Reclone-org/AccessLabs-Resources/hardware/Shaker/Readme.md

# AccessLabs Incubator Shaker

<p align="center">
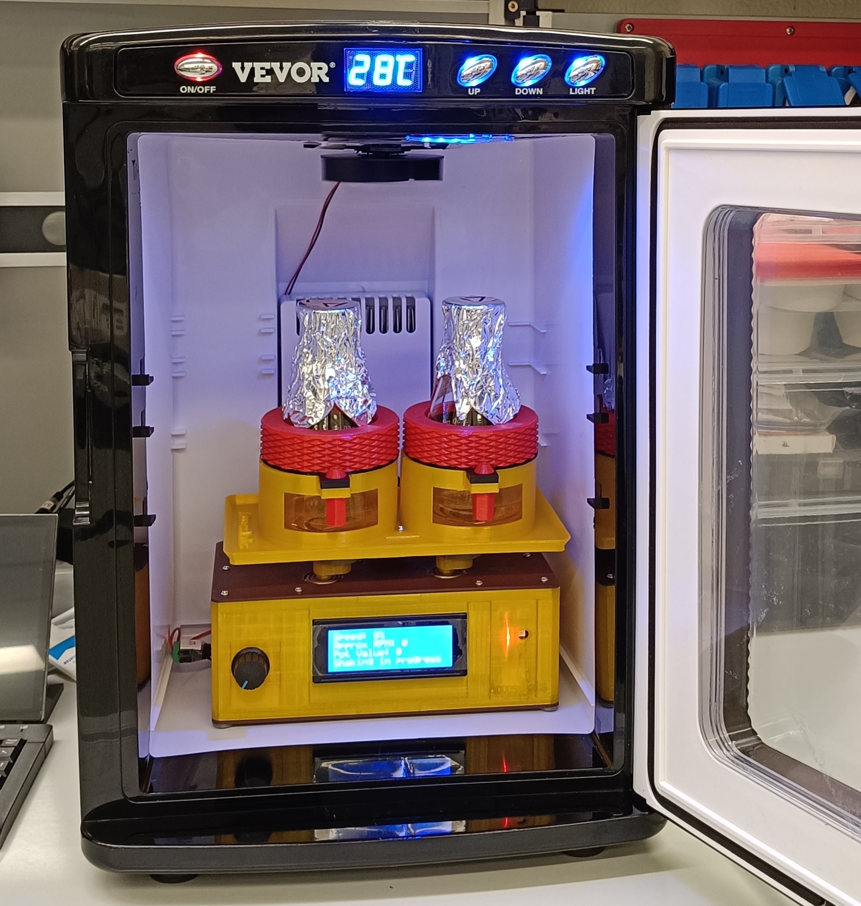
[picture p1: hardware/Shaker/Images/Assmebled1.jpg]
Assembled shaker
  
</p>

<p align="center">
  <strong>3D-printed incubator shaker</strong><br>
  ESP32-S3 controlled, motor-driven, modular, and designed for interchangeable lab vessel adapters.
</p>

<p align="center">
  <em>Prototype hardware documented for replication, testing, and further improvement.</em>
</p>

---

## Overview

This repository documents the design and construction of a compact incubator shaker built around:

- a **3D-printed mechanical assembly**
- an **ESP32-S3 DevKitC-1** controller
- a **DC gear motor**
- a **DRV8871 motor driver**
- interchangeable adapters for **flasks**, **tubes**, and **plates**

The aim of the project is to provide a reproducible open-hardware shaker that is easy to print, assemble, adapt, and improve for different laboratory applications. The shaker was designed with a compact footprint to fit inside small laboratory incubators and operate as a shaking incubator.

---

## Features

- Modular 3D-printed design
- Interchangeable tray adapters
- ESP32-S3 based control
- PWM motor speed control
- LCD and RGB LED feedback
- Open documentation for replication and customization

<p align="center">
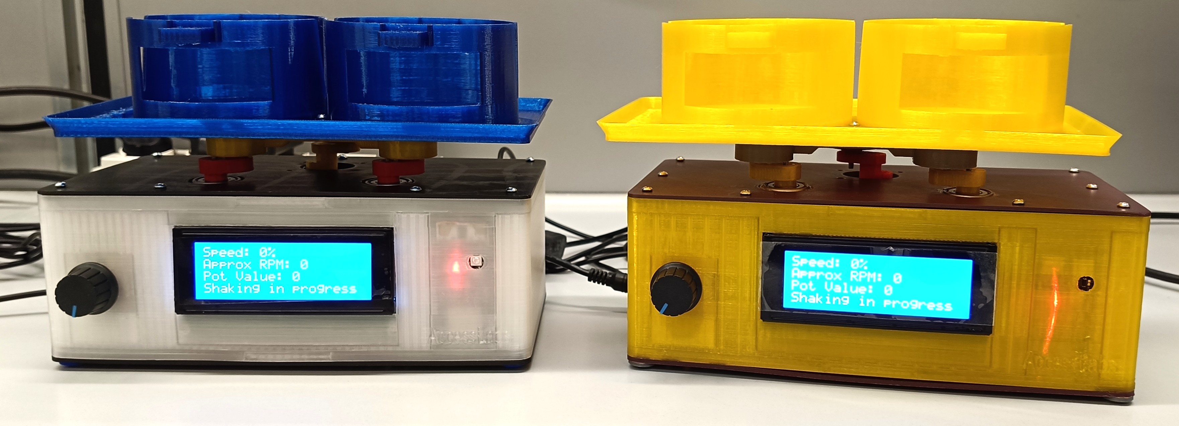
[picture p2: hardware/Shaker/Assembly-and-set-up/Assembled shaker2_1.jpg]
Fully assembled shaker front view
  
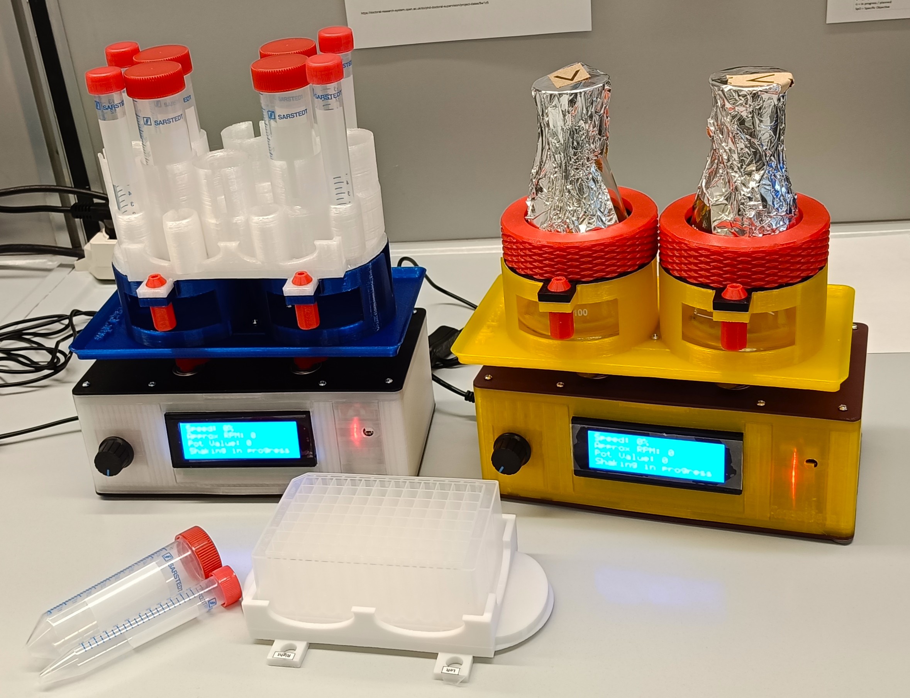
[picture p3: hardware/Shaker/Assembly-and-set-up/Assembled shaker2_2..jpg]
Fully assembled shaker angled view
  
</p>
---

## Bill of Materials

### 3D-printed parts

| Part name | Qty |
|---|---:|
| `Tray_Main Platform` | 1 |
| `Tray_Screws and nuts` | 2 |
| `Flask adapter_Lid` | 2 |
| `Flask adapter_Lid retainer` | 2 |
| `Plate adapter` | 1 |
| `Tube adapter_15 mL and 50 mL` | 1 |
| `Motion Mechanism_Tray Support Bracket` | 1 |
| `Motion Mechanism_Motor motion linker (6mm Shaft)` | 1 |
| `Motion Mechanism_Connecting Link` | 2 |
| `Motion Mechanism_Nut holders` | 2 |
| `Motion Mechanism_Screw holders` | 1 set |
| `Enclosure_Main Housing` | 1 |
| `Enclosure_Gear Motor Mount` | 1 |
| `Enclosure_Top Cover` | 1 |
| `Enclosure_Base Cover` | 1 |
| `Enclosure_Feet` | 1 set |

### 3D model previews

The 3D-printable parts are provided as STL files. Click any animated preview below to open the corresponding STL file in GitHub's interactive 3D viewer.

| Part | Animated preview | STL file |
|---|---|---|
| Enclosure base cover | <a href="3D%20models/Enclosure_Base%20Cover.stl">Enclosure base cover preview</a> | [`Enclosure_Base Cover.stl`](3D%20models/Enclosure_Base%20Cover.stl) |
| Enclosure feet | <a href="3D%20models/Enclosure_Feet.stl">Enclosure feet preview</a> | [`Enclosure_Feet.stl`](3D%20models/Enclosure_Feet.stl) |
| Gear motor mount | <a href="3D%20models/Enclosure_Gear%20Motor%20Mount.stl">Gear motor mount preview</a> | [`Enclosure_Gear Motor Mount.stl`](3D%20models/Enclosure_Gear%20Motor%20Mount.stl) |
| Main housing | <a href="3D%20models/Enclosure_Main%20Housing.stl">Main housing preview</a> | [`Enclosure_Main Housing.stl`](3D%20models/Enclosure_Main%20Housing.stl) |
| Top cover | <a href="3D%20models/Enclosure_Top%20Cover.stl">Top cover preview</a> | [`Enclosure_Top Cover.stl`](3D%20models/Enclosure_Top%20Cover.stl) |
| Flask adapter lid retainer | <a href="3D%20models/Flask%20adapter_Lid%20retainer%20%28Print%202%20copies%29.stl">Flask adapter lid retainer preview</a> | [`Flask adapter_Lid retainer (Print 1 set).stl`](3D%20models/Flask%20adapter_Lid%20retainer%20%28Print%202%20copies%29.stl) |
| Flask adapter lid | <a href="3D%20models/Flask%20adapter_Lid_%28Print%202%20copies%29.stl">Flask adapter lid preview</a> | [`Flask adapter_Lid_(Print 2 copies).stl`](3D%20models/Flask%20adapter_Lid_%28Print%202%20copies%29.stl) |
| Connecting link | <a href="3D%20models/Motion%20Mechanism_Connecting%20Link%20%28Print%20two%20copies%29.stl">Connecting link preview</a> | [`Motion Mechanism_Connecting Link (Print two copies).stl`](3D%20models/Motion%20Mechanism_Connecting%20Link%20%28Print%20two%20copies%29.stl) |
| Motor motion linker | <a href="3D%20models/Motion%20Mechanism_Motor%20motion%20linker%20%286mm%20Shaft%29.stl">Motor motion linker preview</a> | [`Motion Mechanism_Motor motion linker (6mm Shaft).stl`](3D%20models/Motion%20Mechanism_Motor%20motion%20linker%20%286mm%20Shaft%29.stl) |
| Nut holders | <a href="3D%20models/Motion%20Mechanism_Nut%20holders%20%28Print%20two%20copies%29.stl">Nut holders preview</a> | [`Motion Mechanism_Nut holders (Print two copies).stl`](3D%20models/Motion%20Mechanism_Nut%20holders%20%28Print%20two%20copies%29.stl) |
| Screw holders | <a href="3D%20models/Motion%20Mechanism_Screw%20holders.stl">Screw holders preview</a> | [`Motion Mechanism_Screw holders.stl`](3D%20models/Motion%20Mechanism_Screw%20holders.stl) |
| Tray support bracket | <a href="3D%20models/Motion%20Mechanism_Tray%20Support%20Bracket.stl">Tray support bracket preview</a> | [`Motion Mechanism_Tray Support Bracket.stl`](3D%20models/Motion%20Mechanism_Tray%20Support%20Bracket.stl) |
| Plate adapter | <a href="3D%20models/Plate%20adapter.stl">Plate adapter preview</a> | [`Plate adapter.stl`](3D%20models/Plate%20adapter.stl) |
| Tray main platform | <a href="3D%20models/Tray_Main%20Platform.stl">Tray main platform preview</a> | [`Tray_Main Platform.stl`](3D%20models/Tray_Main%20Platform.stl) |
| Tray screws and nuts | <a href="3D%20models/Tray_Screws%20and%20nuts%20%28Print%202%20copies%20of%20each%29.stl">Tray screws and nuts preview</a> | [`Tray_Screws and nuts (Print 2 sets).stl`](3D%20models/Tray_Screws%20and%20nuts%20%28Print%202%20copies%20of%20each%29.stl) |
| Tube adapter, 15 mL and 50 mL | <a href="3D%20models/Tube%20Adapter_15%20mL%20and%2050%20mL.stl">Tube adapter preview</a> | [`Tube Adapter_15 mL and 50 mL.stl`](3D%20models/Tube%20Adapter_15%20mL%20and%2050%20mL.stl) |

### Purchased parts

#### Enclosure and mechanism

| Item | Qty | Cost | Supplier | Notes |
|---|---:|---:|---|---|
| 608ZZ miniature double-protection metal ball bearings (`8 mm x 22 mm x 7 mm`) | 1 | €10.99 | Amazon | / |
| M3 screws, bolts, nuts, and washers kit (`870 pcs`) | 1 | €14.98 | Amazon | / |

#### Electronics

| Item | Qty | Cost | Supplier | Notes |
|---|---:|---:|---|---|
| ESP32-S3 DevKitC-1 microcontroller | 1 | €22.99 | Amazon | Used due to availability. Offers potential for future upgrades. |
| DRV8871 DC motor driver board (`3.6 A`, PWM control) | 2 | €9.99 | Amazon | MOSFET-based H-bridge with lower power loss, higher current handling, wider voltage range, and built-in protection features for improved reliability during prolonged operation. |
| 10K rotary potentiometer with cap and washer | 1 | €8.99 | Amazon | Input device for speed control. |
| 12 V DC worm geared motor (`370WG`, `375 RPM`) | 2 | €18.99 | Amazon | Preferred choice for cost effectiveness. Recommended to use similar motor with high torque and biuilt with better materials for prolonged use. |
| DC barrel power connector / jack adapter set | 1 | €7.99 | Amazon | Includes multiple connectors and inline rocker switches; useful for other projects as well. |
| 12 V power cable / adapter | 2 | €12.90 | Amazon | Portable design with multi-project adapter compatibility reduces future tooling costs. |
| LM2596 step-down DC-DC buck converter module | 1 | €11.19 | Amazon | Required to safely power the full circuit from a single 12 V external adapter via the DC jack. |
| ARCELI 20x4 2004 5 V DC LCD display module with TWI/IIC I2C interface adapter (`Blue/2004`) | 1 | €10.77 | Amazon | Used for system status display, speed display, and approximate RPM readout. I2C interface simplifies wiring to the ESP32-S3. |

### Tools and consumables

- Strong instant glue
- Screwdriver set
- Soldering station
- Jumper wires
- Double sided tape
---

## Printing recommendations

For the **critical structural and motion parts**, use **PETG** or a similar durable filament.

### Recommended print settings
- **Infill:** at least **50%**
- **Supports:** use where needed
- **Brim:** use where needed for better bed adhesion

### Critical parts
- `Enclosure_Main Housing`
- `Enclosure_Feet`
- all motion mechanism parts
- `Tray_Main Platform`
- `Tray_Screws and nuts`

### Notes
- Remove supports and brims carefully after printing.
- Clean mating surfaces and holes before assembly.
- Check bearing and nut pockets before gluing.

---

## Parts Gallery

The images below are arranged by function and labeled with the current filenames in the repository.

### 1. Tray and adapters

<table>
  <tr>
    <td align="center" width="33%">
      <strong>Tray_Main Platform.jpg</strong><br><br>
      Tray_Main Platform.jpg
    </td>
    <td align="center" width="33%">
      <strong>Tray_Screws and nuts.jpg</strong><br><br>
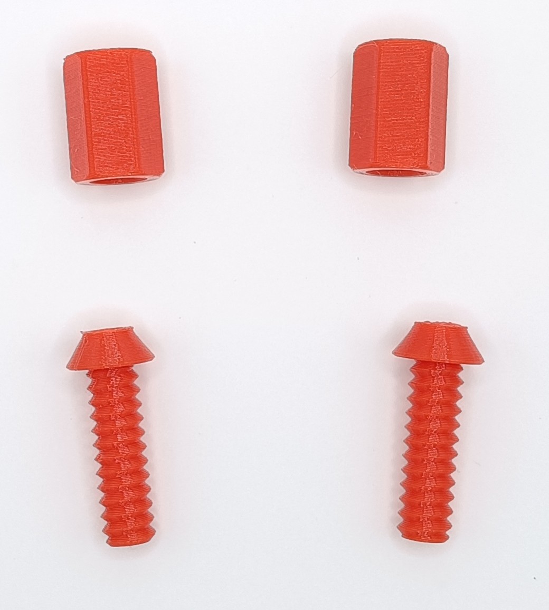
[picture p4: hardware/Shaker/Images/Tray_Screws and nuts.jpg]
Tray_Screws and nuts.jpg
      
    </td>
    <td align="center" width="33%">
      <strong>Plate adapter.jpg</strong><br><br>
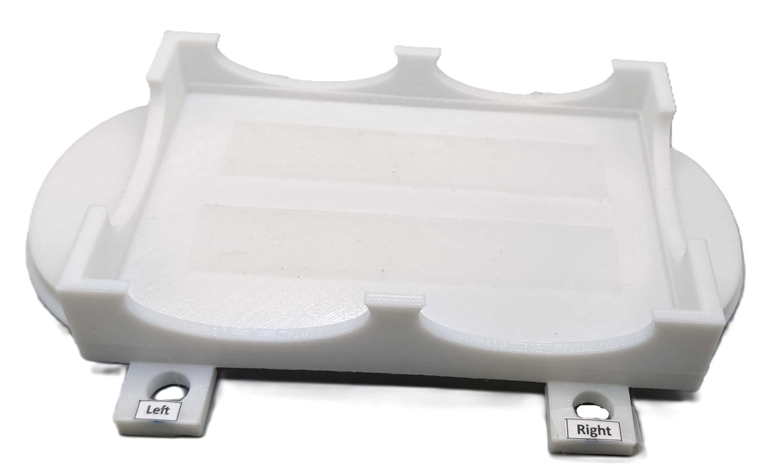
[picture p5: hardware/Shaker/Images/Plate adapter.jpg]
Plate adapter.jpg
      
    </td>
  </tr>
  <tr>
    <td align="center" width="33%">
      <strong>Tube adapter_15 mL and 50 mL.jpg</strong><br><br>
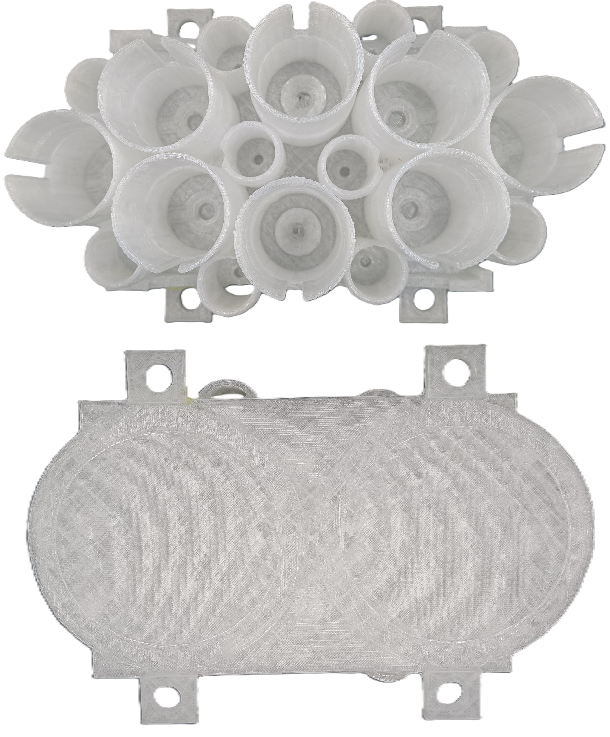
[picture p6: hardware/Shaker/Images/Tube adapter_15 mL and 50 mL.jpg]
Tube adapter_15 mL and 50 mL.jpg
      
    </td>
    <td align="center" width="33%">
      <strong>Flask adapter_Lids .jpg</strong><br><br>
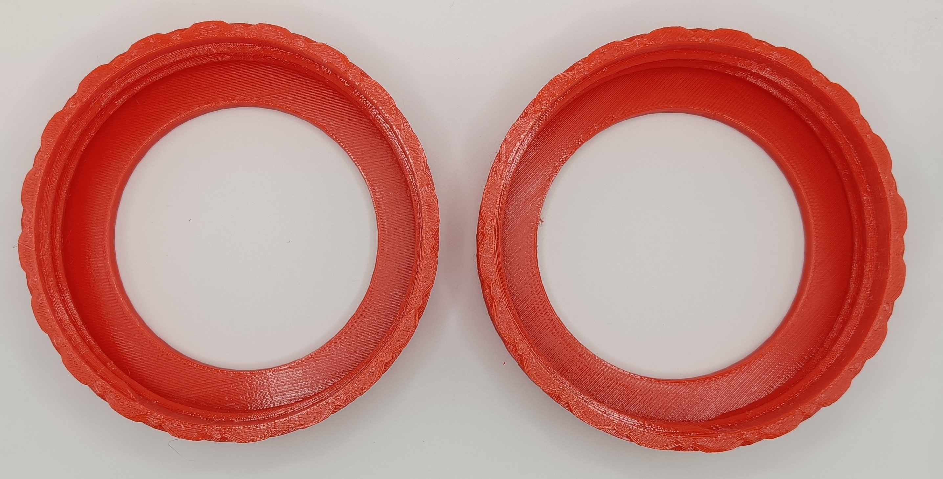
[picture p7: hardware/Shaker/Images/Flask adapter_Lids .jpg]
Flask adapter_Lids .jpg
      
    </td>
    <td align="center" width="33%">
      <strong>Flask adapter_Lid retainers.jpg</strong><br><br>
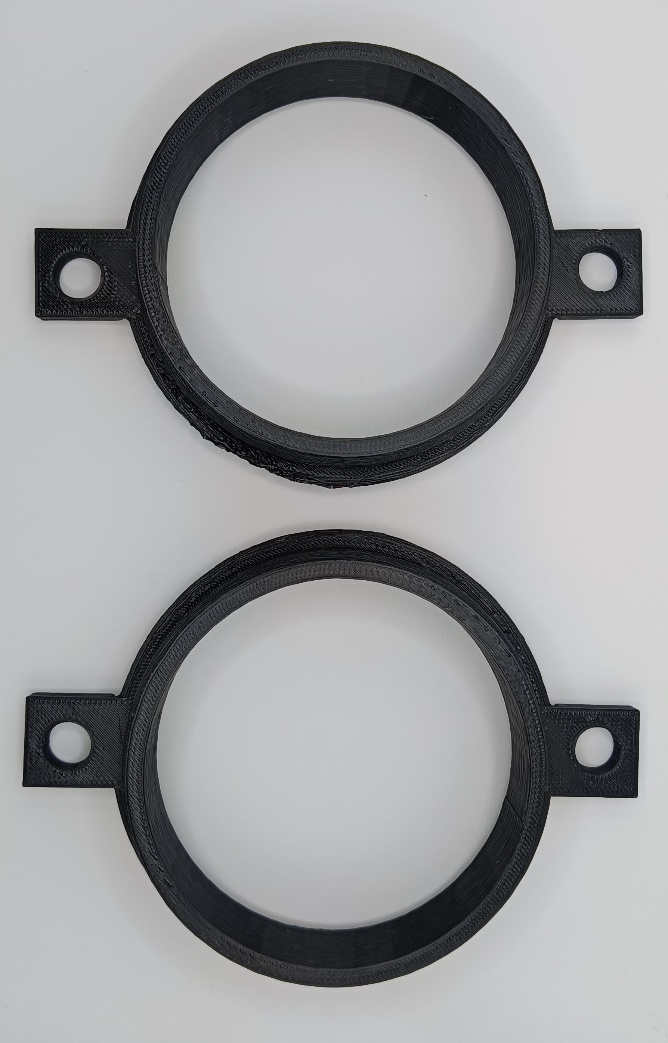
[picture p8: hardware/Shaker/Images/Flask adapter_Lid retainers.jpg]
Flask adapter_Lid retainers.jpg
      
    </td>
  </tr>
</table>

### 2. Motion assembly

<table>
  <tr>
    <td align="center" width="100%">
      <strong>Motion Mechanism parts.jpg</strong><br><br>
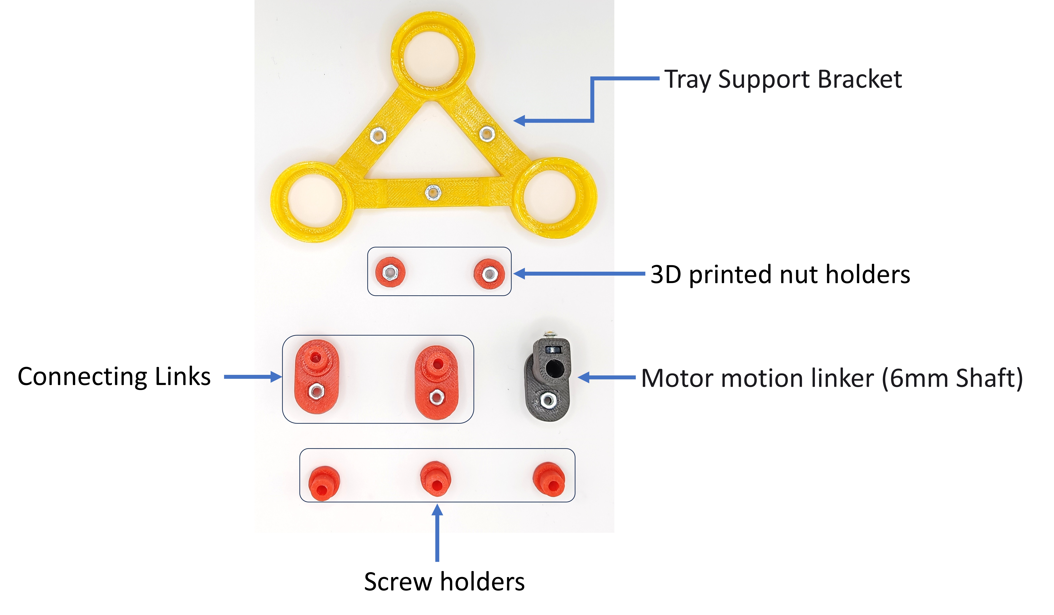
[picture p9: hardware/Shaker/Images/Motion Mechanism parts.jpg]
Motion Mechanism parts.jpg
      
    </td>
  </tr>
</table>

### 3. Enclosure

<table>
  <tr>
    <td align="center" width="33%">
      <strong>Enclosure_Main Housing.jpg</strong><br><br>
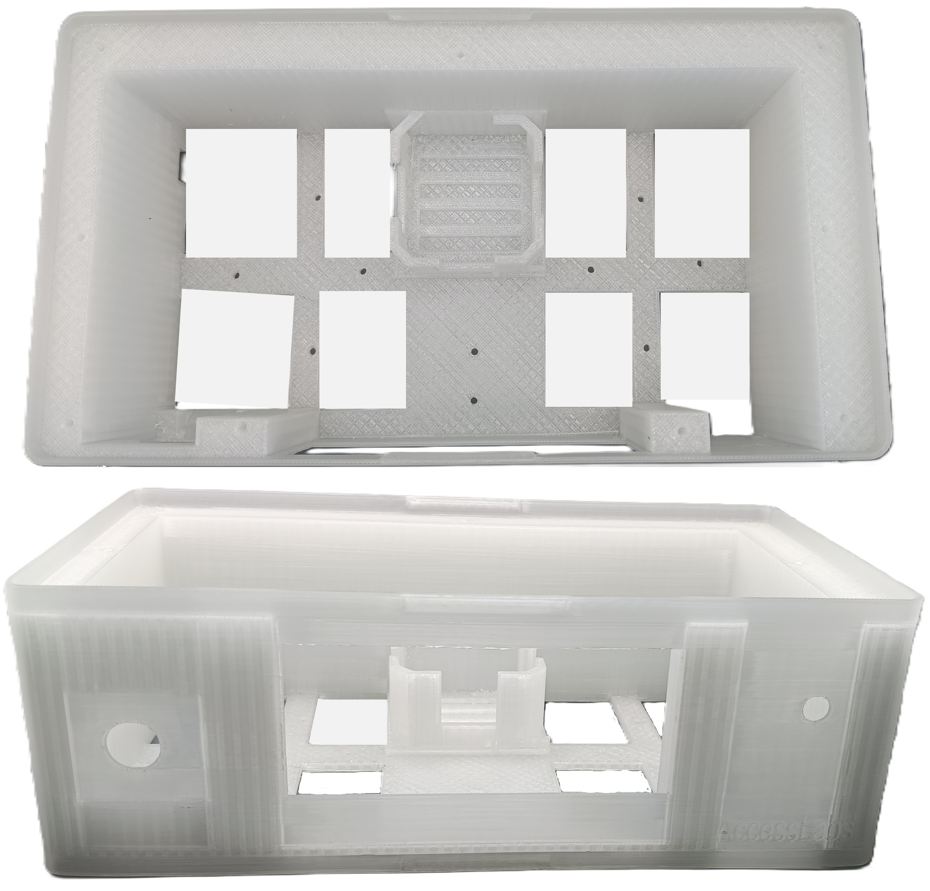
[picture p10: hardware/Shaker/Images/Enclosure_Main Housing.jpg]
Enclosure_Main Housing.jpg
      
    </td>
    <td align="center" width="33%">
      <strong>Enclosure_Top Cover.jpg</strong><br><br>
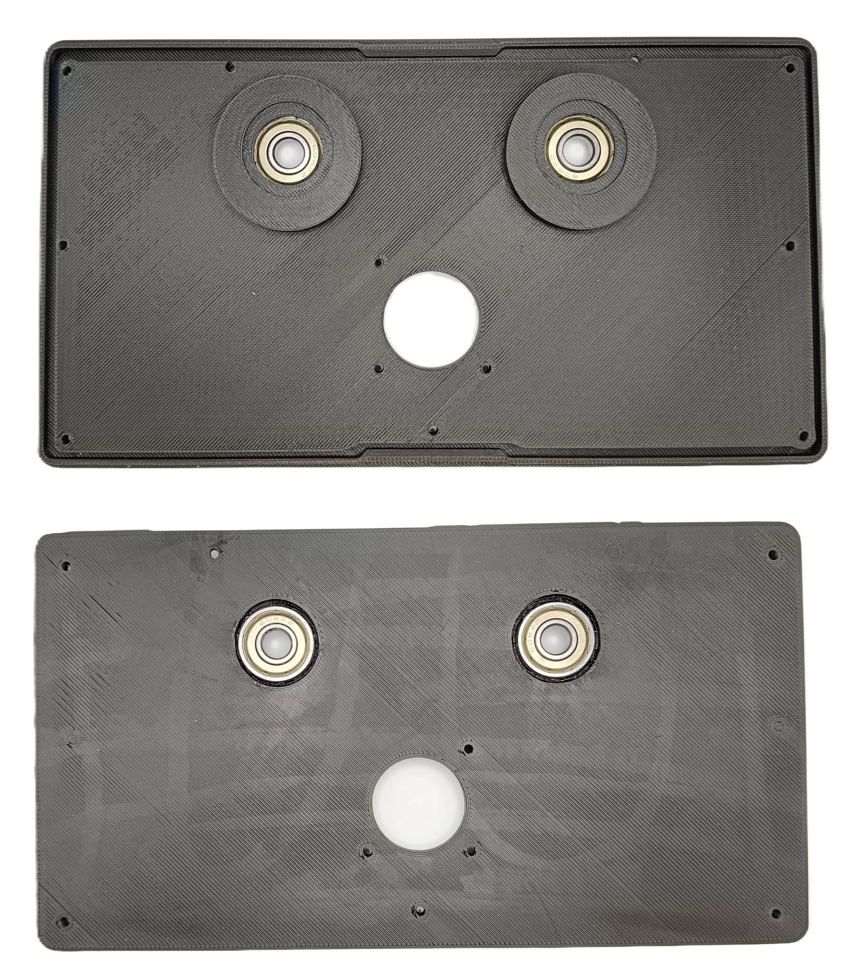
[picture p11: hardware/Shaker/Images/Enclosure_Top Cover.jpg]
Enclosure_Top Cover.jpg
      
    </td>
    <td align="center" width="33%">
      <strong>Enclosure_Base Cover.jpg</strong><br><br>
      Enclosure_Base Cover.jpg
    </td>
  </tr>
</table>

---

## Assembly

### A. Print and sort all parts

Download the 3D models and print all required parts.

After printing:
1. Remove all supports and brims.
2. Clean all holes and mating surfaces.
3. Sort the parts before starting assembly.

Recommended first check:
- verify that all bearings fit correctly
- verify that all nut pockets are clean
- verify that moving parts rotate freely

---

### B. Prepare the motion mechanism

#### Parts involved
- `Motion Mechanism_Motor motion linker (6mm Shaft)`
- `Motion Mechanism_Connecting Link`
- `Motion Mechanism_Nut holders`
- `Motion Mechanism_Screw holders`
- `Motion Mechanism_Tray Support Bracket`

#### Instructions
1. Dry-fit each M3 nut and 608ZZ bearing before gluing.
2. Apply a small amount of strong liquid glue around the nut or bearing pocket.
3. Insert the nut or bearing carefully.
4. Do **not** let glue enter:
   - threaded areas
   - the inner bearing race
   - rotating contact surfaces
5. Let the glue set for about **30 minutes**.
6. Add a small finishing layer at the interstices if needed.
7. Allow full curing according to the glue manufacturer's recommendations.

<p align="center">
  Assembly steps 1: Motion Mechanism
</p>

<p align="center">
  <em>Assembly steps 1.</em>
</p>

> **Note:** For the motor linker, the nut located around the shaft should remain unglued if required for fit and rotation.
---

### C. Prepare the enclosure

#### Parts involved
- `Enclosure_Main Housing`
- `Enclosure_Gear Motor Mount`
- `Enclosure_Top Cover`
- `Enclosure_Base Cover`
- `Enclosure_Feet`

#### Instructions
1. Install bearings in their dedicated holes of the top cover where applicable.
> **Note:**: use soft glue to fix bearings so as to enable slide movements of once glued: we used the **super 620, Glue Artiglio** which worked well for us
2. Assemble the top cover
3. Mount the gear motor in the motor holder.
4. Test fit the top and base covers before electronics assembly.
5. Check shaft alignment before tightening hardware.

<p align="center">
  Assembly steps 2
</p>

<p align="center">
  <em>Assembly steps 2.</em>
</p>

#### Top Cover assembly order

Click the preview below to download the full video.

<p align="center">
  <a href="https://github.com/Reclone-org/AccessLabs-Resources/blob/76ed58e3b9f4448dbe461207be13629689c9c077/hardware/Shaker/Assembly-and-set-up/Top%20cover%20assembly.mp4">
    Top Cover assembly order
  </a>
</p>

---

### D. Electronics assembly

#### Main electronics

- ESP32-S3 DevKitC-1
- DRV8871 motor driver
- 10K rotary potentiometer
- ARCELI 20x4 2004 LCD display module with TWI/IIC I2C interface (`5 V`, `Blue/2004`)
- LM2596 step-down DC-DC buck converter
- 12 V DC worm geared motor (`370WG`, `375 RPM`)
- 12 V DC input connector

#### Electronics overview

<p align="center">
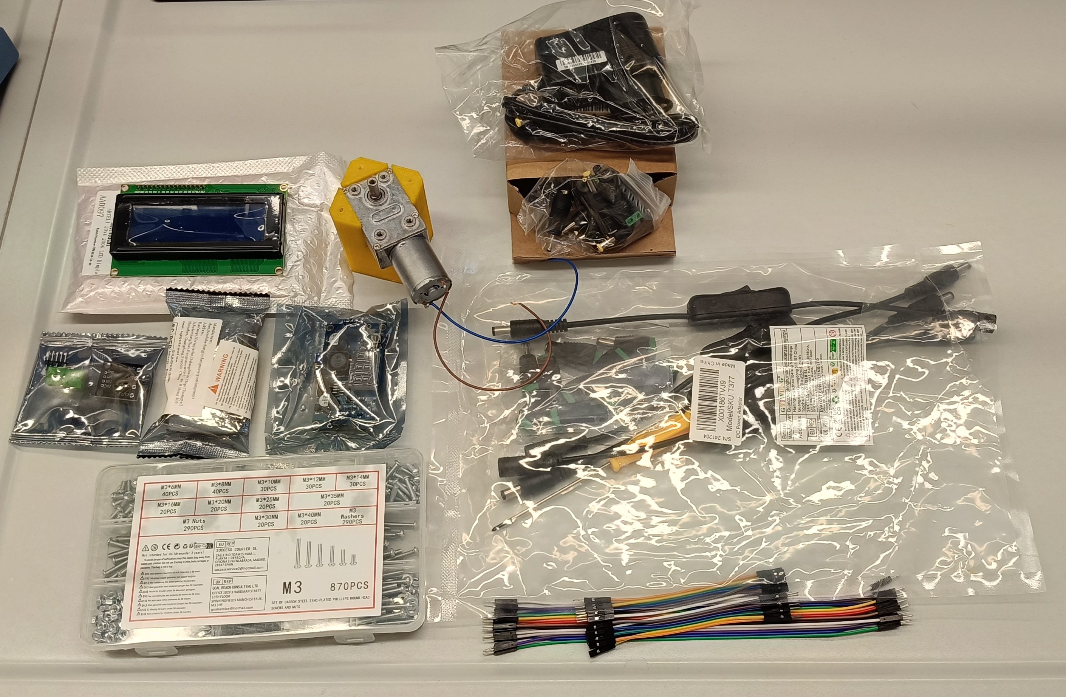
[picture p12: hardware/Shaker/Images/Electrionics parts .jpg]
Electronics parts overview
  
</p>

<p align="center">
  <em>Electronics parts used for the shaker build.</em>
</p>

#### Instructions

1. **Prepare the motor driver**  
   Solder the DRV8871 motor driver board according to the manufacturer's instructions.

2. **Connect the power input**  
   Connect the DC barrel power connector to the **input** of the LM2596 buck converter.

3. **Set the regulated output**  
   Power the LM2596 from the 12 V input.  
   Adjust the onboard potentiometer until the output is **5 V**.

4. **Wire the low-voltage electronics**  
   Connect the regulated **5 V** output and **GND** from the LM2596 to the ESP32-S3 and the LCD power lines.

5. **Connect the LCD**  
   Wire the LCD I2C backpack to:
   - **5 V**
   - **GND**
   - **SDA** on the ESP32-S3 (pin 21)
   - **SCL** on the ESP32-S3 (pin 17)

6. **Connect the control circuit**  
   Wire the potentiometer, DRV8871, ESP32-S3, and motor according to the wiring diagram.

7. **Check the wiring**  
   Before powering the full circuit, confirm that:
   - all grounds are shared
   - the LM2596 output is set to **5 V**
   - the LCD is powered from **5 V**
   - the correct pins are used for **SDA** and **SCL**
   - the ESP32-S3 pins match the firmware
   - wires are secure and clear of moving parts

#### Wiring diagram

<p align="center">
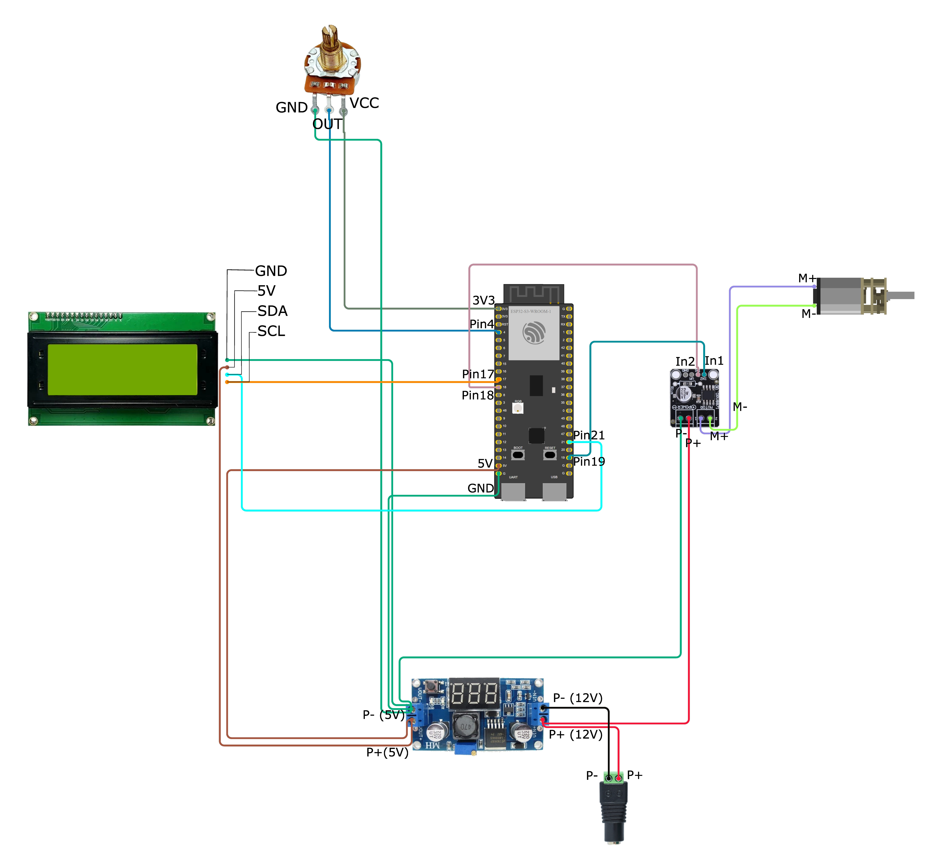
[picture p13: hardware/Shaker/Images/Circuit_Design.jpg]
Wiring diagram
  
</p>

<p align="center">
  <em>Wiring diagram for the shaker electronics assembly.</em>
</p>

#### Electronic assembly overview
<p align="center">
  Electronic assembly overview
</p>

<p align="center">
  <em>Electronic assembly overview.</em>
</p>

8. **Run a bench test**  
   Power the circuit and confirm that:
   - the ESP32-S3 starts correctly
   - the LCD initializes correctly (If needed, adjust the screen brightness by turning the contrast knob.)
   - the potentiometer input responds correctly
   - the motor driver powers on
   - the motor runs as expected

> **Important:** If you use a different ESP32 board, LCD backpack, or pin mapping, check the pinout and update the wiring and firmware as needed.

#### Circuit assembly and bench testing 
<p align="center">
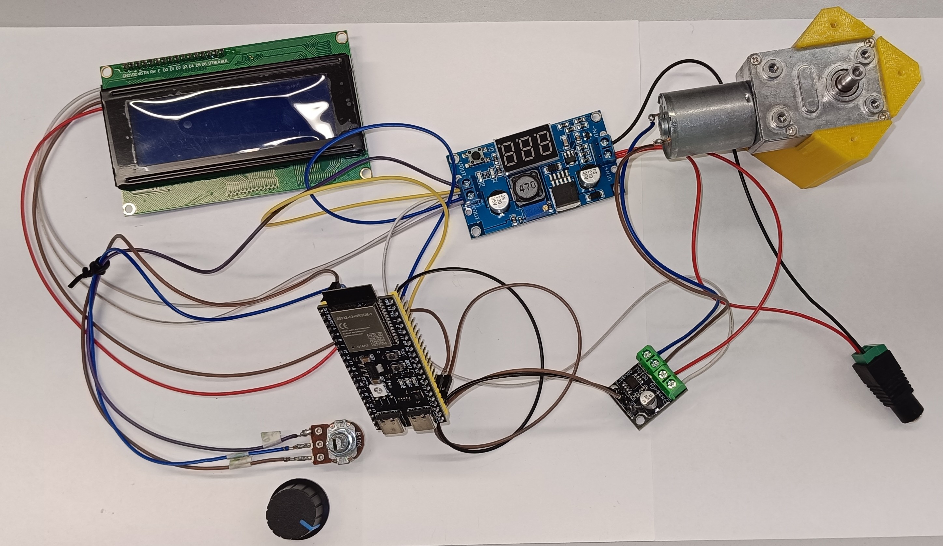
[picture p14: hardware/Shaker/Electronics/Assembled Circuit.jpg]
Electronic circuit assembly
  
</p>

<p align="center">
  <em>Electronic circuit assembly.</em>
</p>

<p align="center">
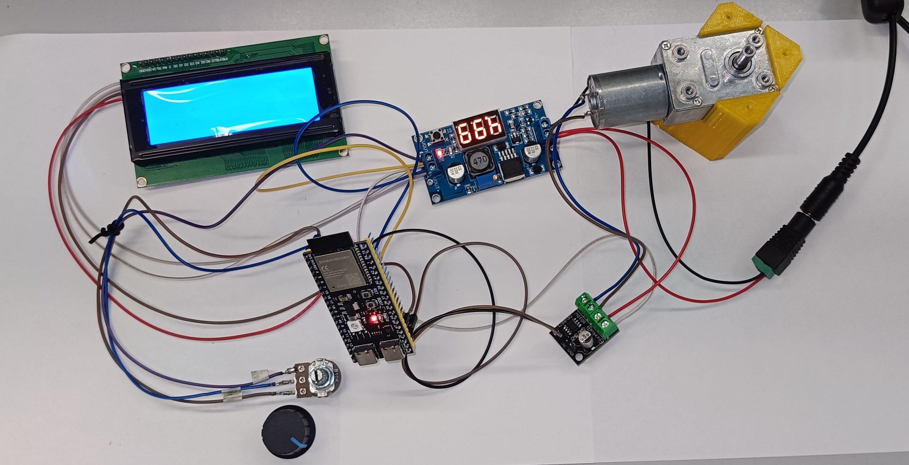
[picture p15: hardware/Shaker/Electronics/Testing the Circuit.jpg]
Bench testing
  
</p>

<p align="center">
  <em>Bench testing.</em>
</p>
---

### E. Firmware

The firmware acts as the control system for the shaker.

#### Main behavior
- scans the I2C bus at startup
- initializes the LCD
- runs a short boot animation
- reads and averages potentiometer values
- maps the input to PWM motor speed
- estimates RPM for display
- updates the LCD with:
  - speed percentage
  - approximate RPM
  - raw potentiometer value

#### Speed control logic
A dead zone is used so the shaker remains reliably off at low potentiometer values.

- `0` to about `1264` → motor off
- above `1264` → mapped linearly to PWM output
- the displayed RPM is an approximation and not encoder measured

---

### F. Software installation

#### Prerequisites

Before uploading the firmware:

1. Make sure the circuit is **not powered on**.
2. Connect the **ESP32-S3 DevKitC-1** to the computer using the board programming/COM port.
3. Install **Arduino IDE**.
4. Download the firmware from the software folder:

   [Shaker software folder](https://github.com/Reclone-org/AccessLabs-Resources/tree/841adbdfd7efff96190e474088e382160f662ce2/hardware/Shaker/Software)

5. Open the firmware file:

   **`Shaker 2.0_Program_DRV8871.ino`**

#### Using Arduino IDE

1. Open **Arduino IDE**.
2. Open the shaker firmware sketch:

   **`Shaker 2.0_Program_DRV8871.ino`**

3. Go to **Tools**.
4. Go to **Board**.
5. Select **ESP32S3 Dev Module**.

   Board selection reference:

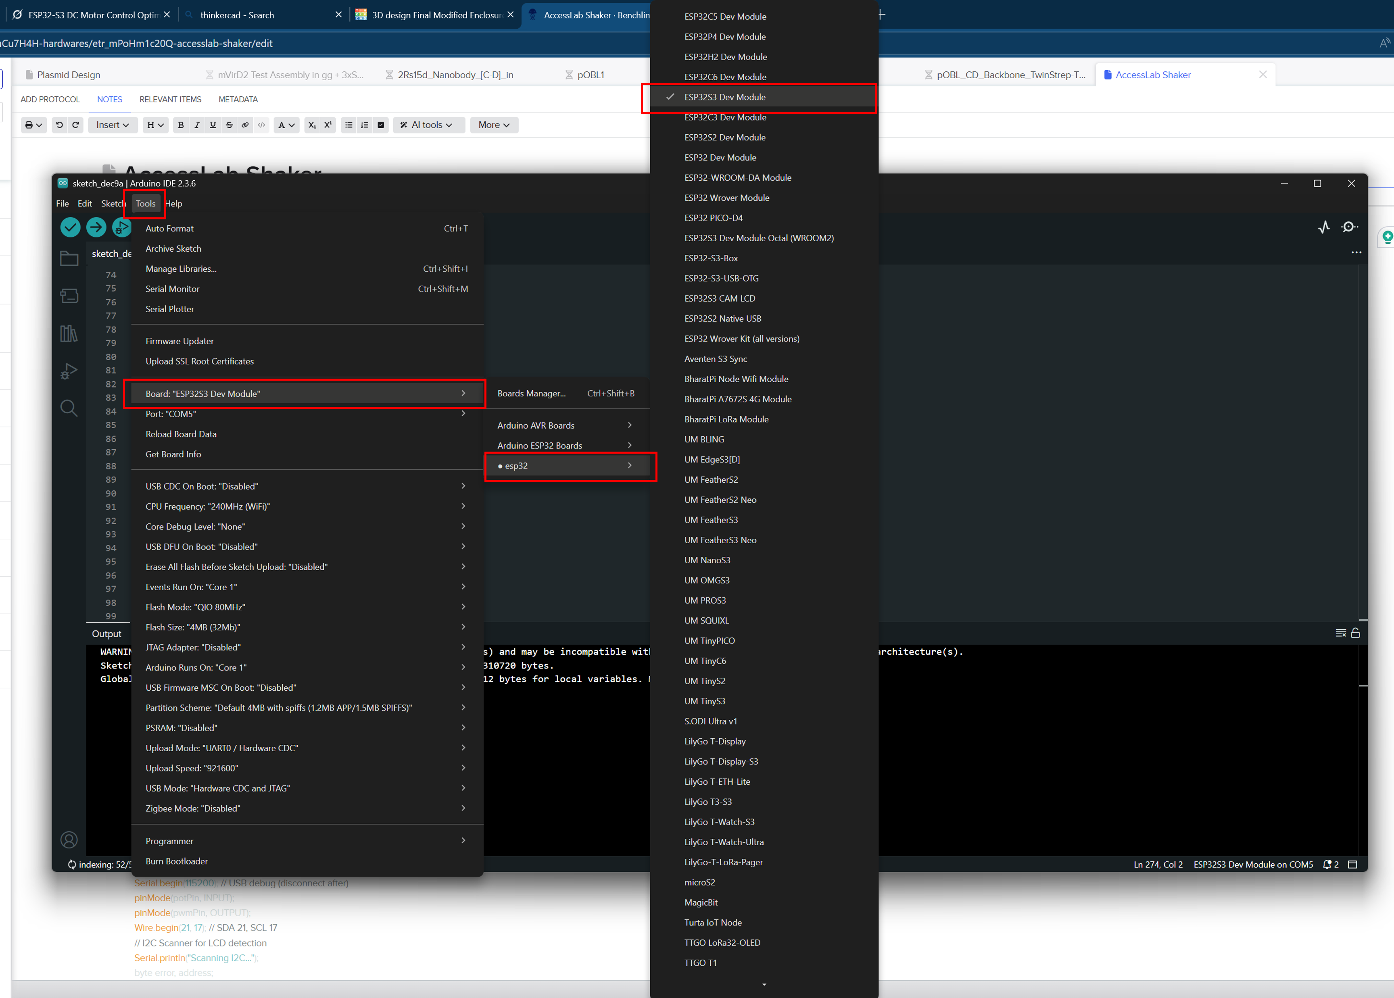
[picture p16: hardware/Shaker/Images/Board selection.png]
Board selection in Arduino IDE
   

6. Select the correct serial **Port**.
7. Click **Verify** to compile the firmware.

   Compile sketch reference:

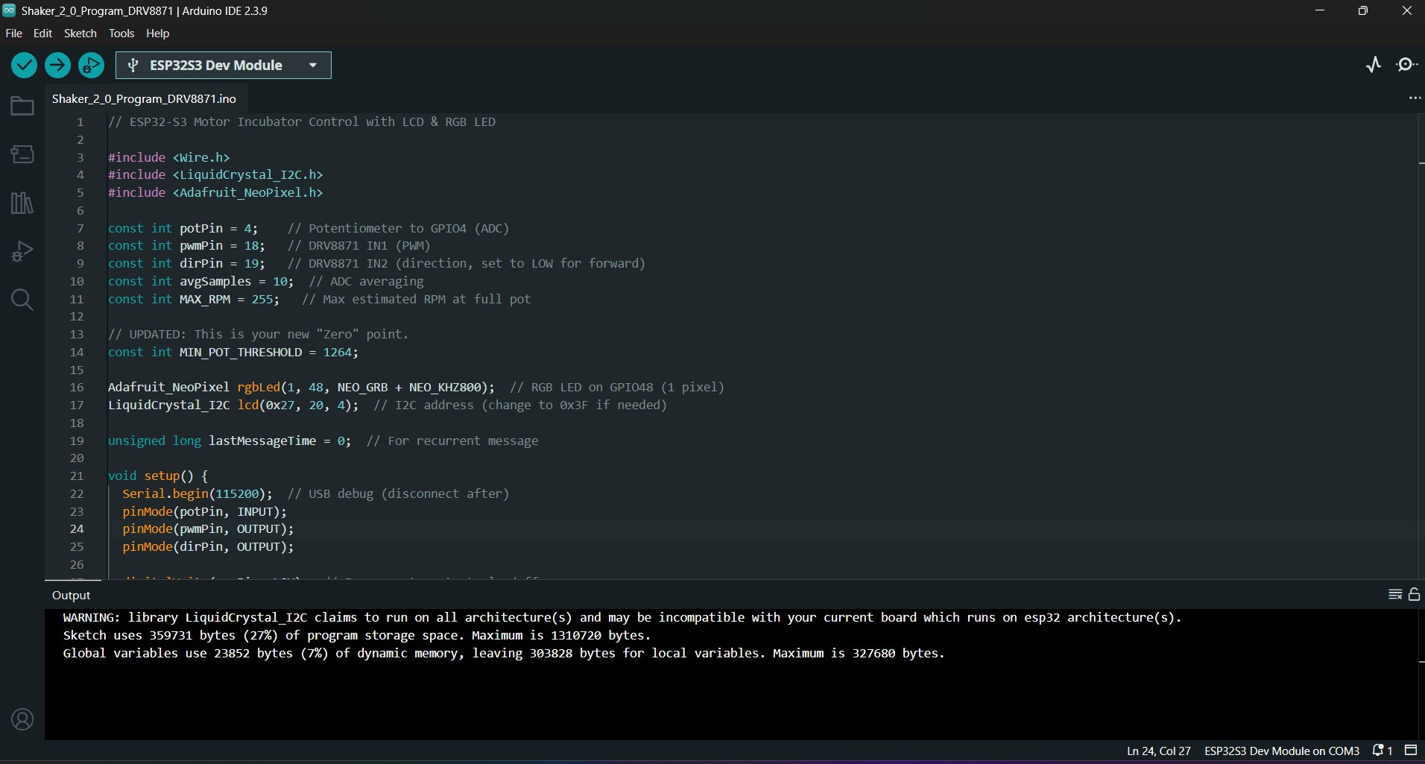
[picture p17: hardware/Shaker/Images/Compile sketch_2026-05-12 054341.jpg]
Compile sketch in Arduino IDE
   

   > **Note:** It is acceptable to ignore the warning message shown during compilation, as long as the sketch compiles successfully and no upload-blocking error is reported.

8. Click **Upload** to upload the firmware to the ESP32-S3.
9. Once the upload is complete, unplug the cable from the programming/COM port.
10. Power the circuit and confirm that the shaker circuit behaves as expected.
---

### G. Testing

Before final assembly, perform a bench test to confirm that the electronics and firmware behave as expected.

#### Bench test preview

Bench test showing circuit behavior after firmware upload

#### Test checklist

1. Power the system.
2. Confirm that the **ESP32-S3** starts correctly.
3. Confirm that the LCD initializes correctly. If needed, adjust the screen brightness by turning the contrast knob.
4. Confirm that the potentiometer changes the displayed value.
5. Confirm that the motor responds smoothly to PWM control.

---

### H. Final assembly

Route and secure all wiring inside the enclosure.

1. Install the power jack:
   - Place the power jack in its dedicated position. (add soft glue to firmly fix it)
   - Close the bottom lid to help keep the jack correctly positioned.

2. Install the LCD screen:
   - Insert the LCD screen into the dedicated opening in the enclosure.
   - The fit is intentionally tight so that the screen can be held in place without screws or glue.
   - Apply gentle, even pressure when inserting the screen until it sits firmly in place.

3. Install the motor:
   - Place the motor into the motor holder.
   - Make sure it is seated correctly and does not move during operation.

4. Install the ESP32-S3 board:
   - Place the ESP32-S3 board inside the enclosure.
   - Use double-sided tape to secure it to the enclosure wall.
   - Adjust the board position so that the RGB LED aligns with the corresponding hole in the enclosure.

5. Install the potentiometer:
   - Remove the nut and washer from the potentiometer.
   - Insert the potentiometer from inside the enclosure.
   - Reinstall the washer and nut from the outside of the enclosure to secure it in place.

#### Peview before testing assembled system
<p align="center">
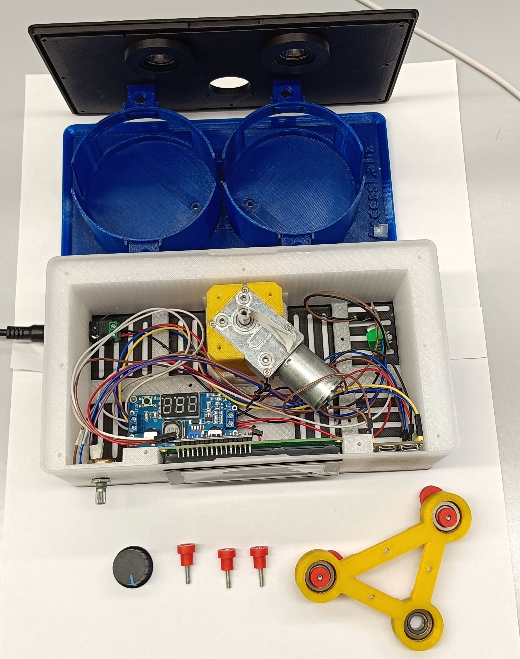
[picture p18: hardware/Shaker/Assembly-and-set-up/Preview before final test.jpg]
Peview before testing assembled system
  
</p>

6. Run a low-speed test before regular operation.

#### System test preview

System test after mounting all parts in the enclosure

7. Close the enclosure using the top and bottom covers.

8. Install the tray support and motion mechanism.

9. Glue the feet to the bottom of the enclosure.

10. Screw the top and bottom enclosure covers in place.

## 🔩 Screws and fasteners

The shaker design uses **M3 screws and nuts** for the main mechanical assembly.

Screw holes are intentionally designed to be tight. This allows the screw to create its own path while being inserted, which helps the parts hold firmly once assembled. Because of this, the screws may be harder to insert the first time.

### Suggested screw dimensions

| Assembly part | Suggested screw size |
|---|---|
| Motion mechanism screw holders | M3 × 16 mm |
| Top and bottom enclosure covers | M3 × 10 mm |
| Screws inside the main box | M3 × 12 mm |
| Motion mechanism motor motion linker | M3 × 8 mm |
| Motion mechanism Connecting Link | M3 × 20 mm |
| Tray main platform | M3 × 20 mm |

> **Note:** These screw lengths were used for this build, but they can be adjusted depending on your print quality, material, and assembly needs. The most important point is to choose a screw length that is long enough to hold the parts securely, but not so long that it damages the printed part, blocks movement, or interferes with the motion mechanism.
    
11. Screw the tray main platform.

12. Fit the required vessel adapter:
   - flask adapter
   - tube adapter
   - plate adapter
     
## 📸 Assembled shaker gallery

The images below show the fully assembled incubator shaker from different angles.

<table>
  <tr>
    <td align="center" width="33%">
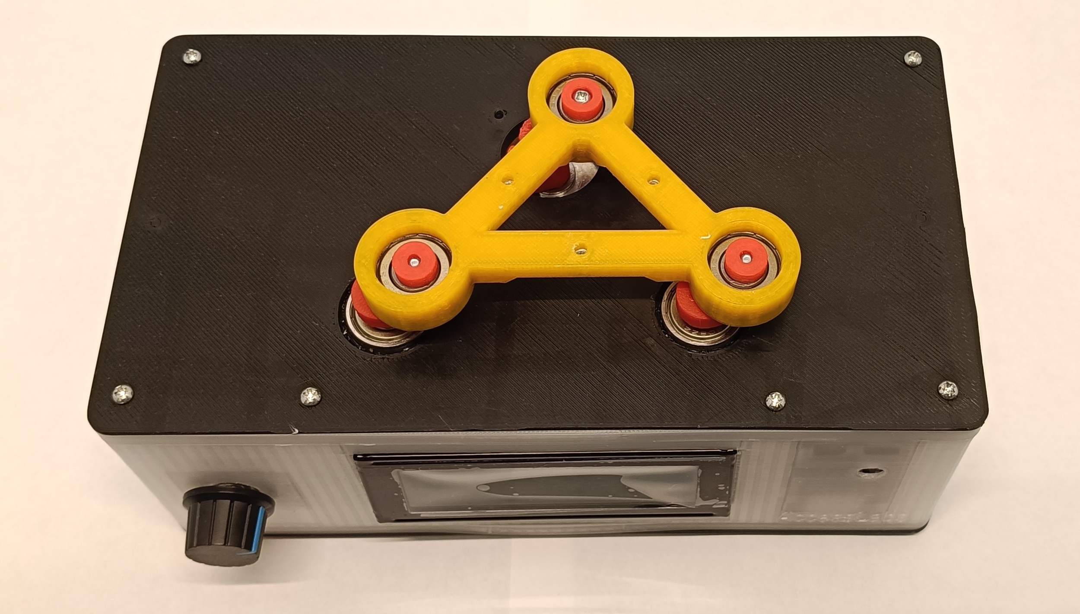
[picture p19: hardware/Shaker/Images/Assembled shaker/IMG20260530154236.jpg]
Assembled shaker view 1
      
    </td>
    <td align="center" width="33%">
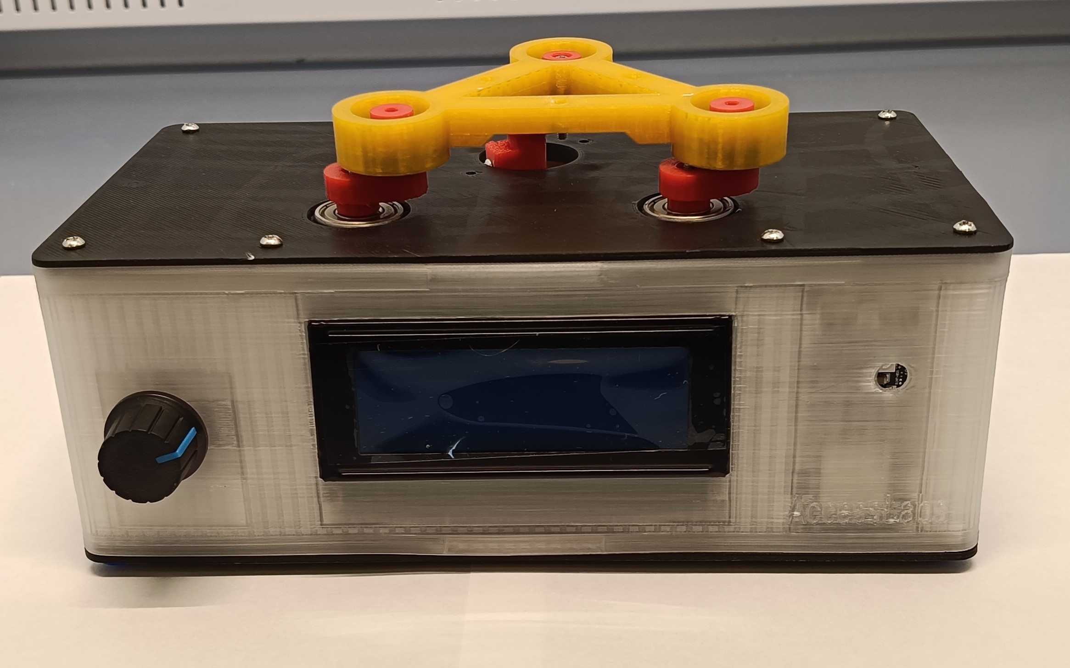
[picture p20: hardware/Shaker/Images/Assembled shaker/IMG20260530154253.jpg]
Assembled shaker view 2
      
    </td>
    <td align="center" width="33%">
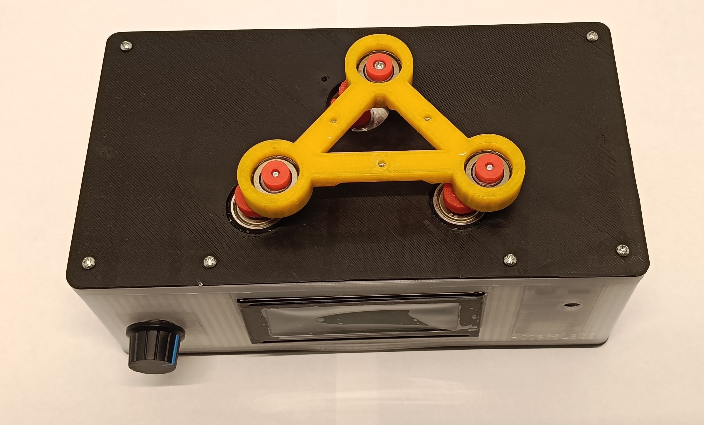
[picture p21: hardware/Shaker/Images/Assembled shaker/IMG20260530154257.jpg]
Assembled shaker view 3
      
    </td>
  </tr>
  <tr>
    <td align="center" width="33%">
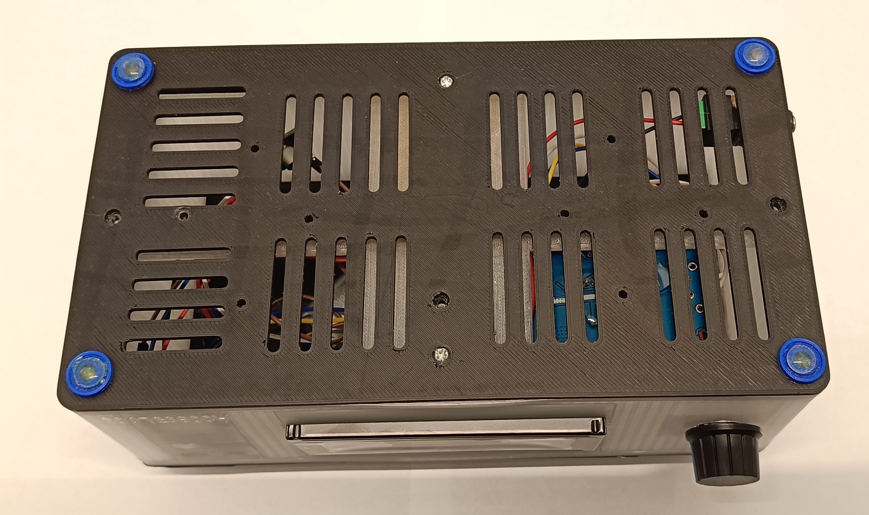
[picture p22: hardware/Shaker/Images/Assembled shaker/IMG20260530154315.jpg]
Assembled shaker view 4
      
    </td>
    <td align="center" width="33%">
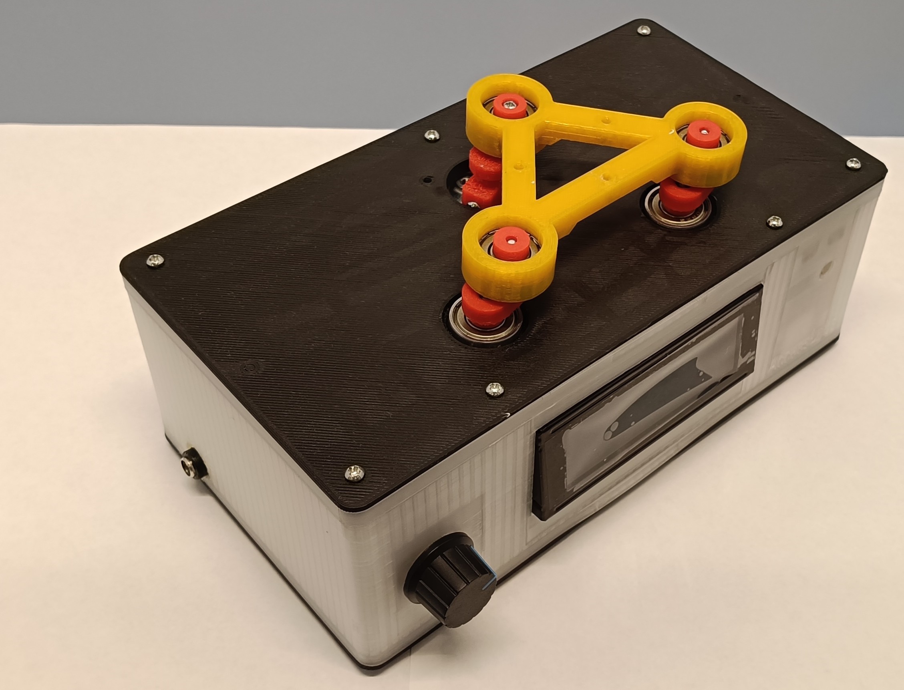
[picture p23: hardware/Shaker/Images/Assembled shaker/IMG20260530154404.jpg]
Assembled shaker view 5
      
    </td>
    <td align="center" width="33%">
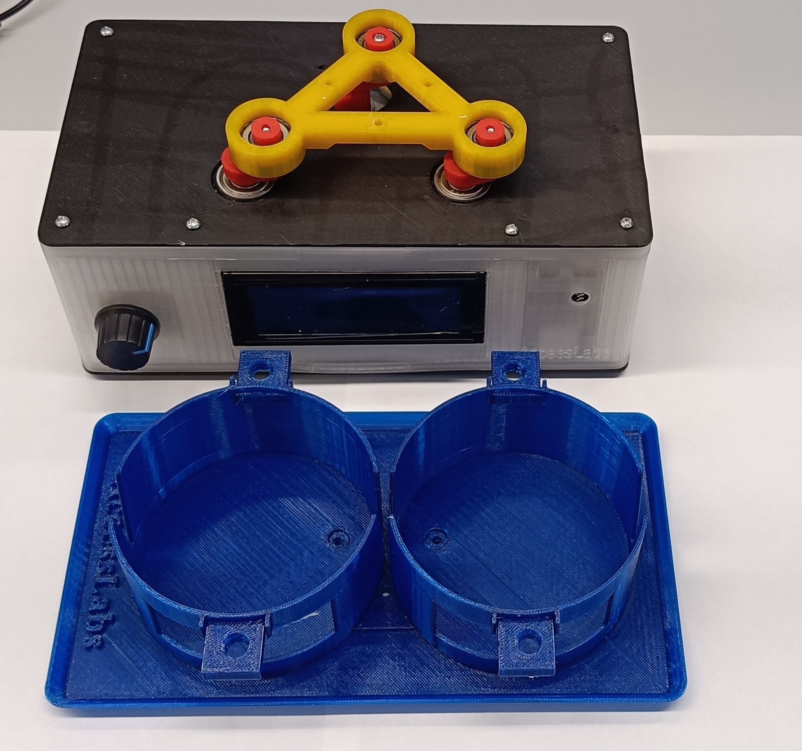
[picture p24: hardware/Shaker/Images/Assembled shaker/IMG20260530154522.jpg]
Assembled shaker view 6
      
    </td>
  </tr>
  <tr>
    <td align="center" width="33%">
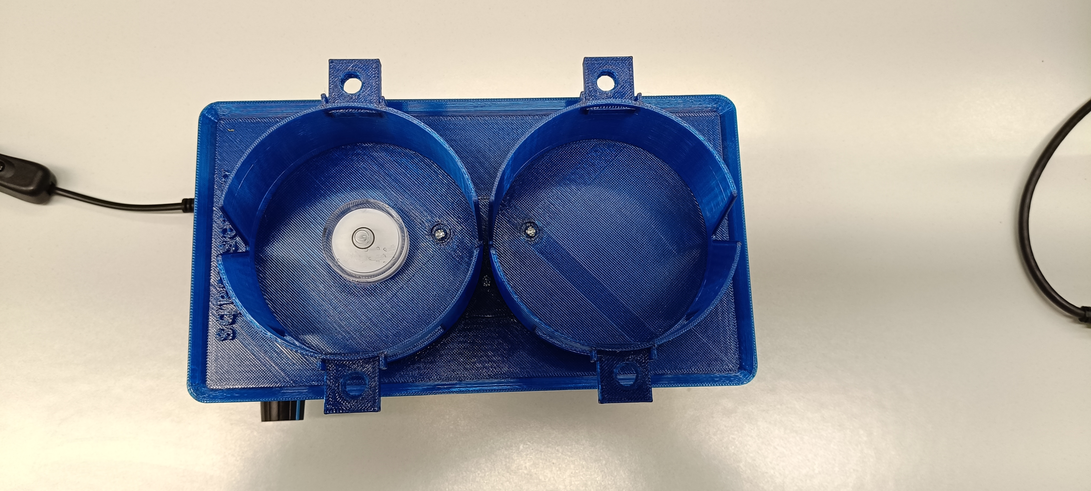
[picture p25: hardware/Shaker/Images/Assembled shaker/IMG20260604145715.jpg]
Assembled shaker view 7
      
    </td>
    <td align="center" width="33%">
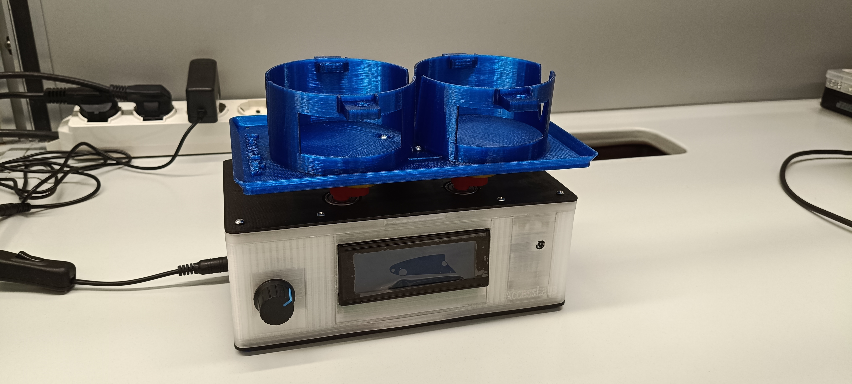
[picture p26: hardware/Shaker/Images/Assembled shaker/IMG20260604145742.jpg]
Assembled shaker view 8
      
    </td>
    <td align="center" width="33%">
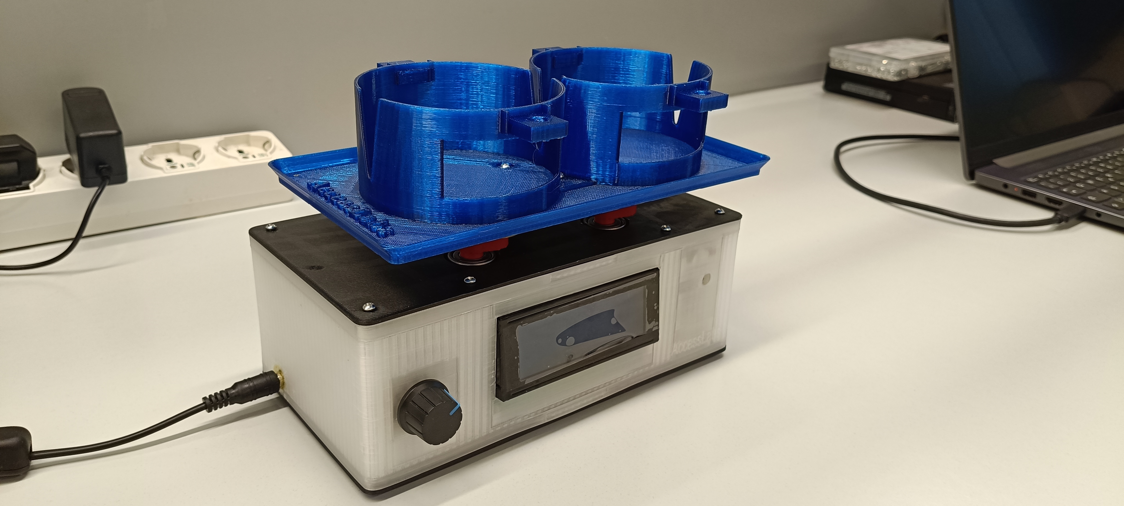
[picture p27: hardware/Shaker/Images/Assembled shaker/IMG20260604145746.jpg]
Assembled shaker view 9
      
    </td>
  </tr>
  <tr>
    <td align="center" width="33%">
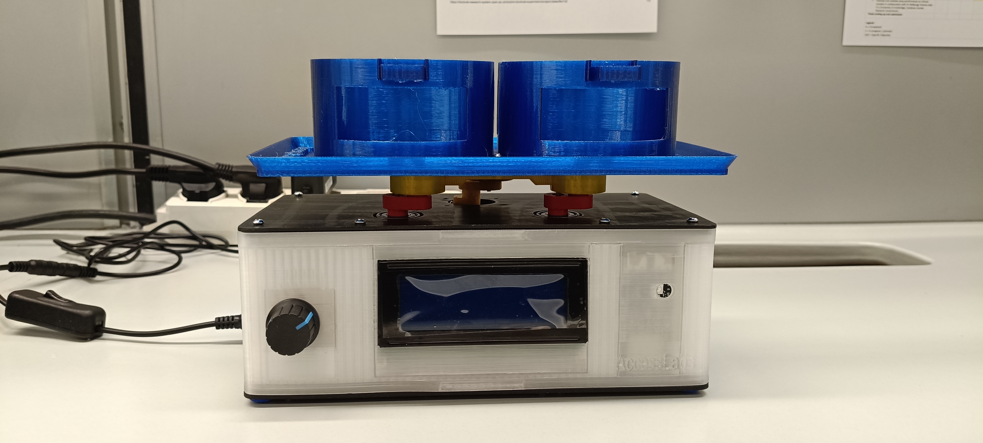
[picture p28: hardware/Shaker/Images/Assembled shaker/IMG20260604145802.jpg]
Assembled shaker view 10
      
    </td>
    <td align="center" width="33%">
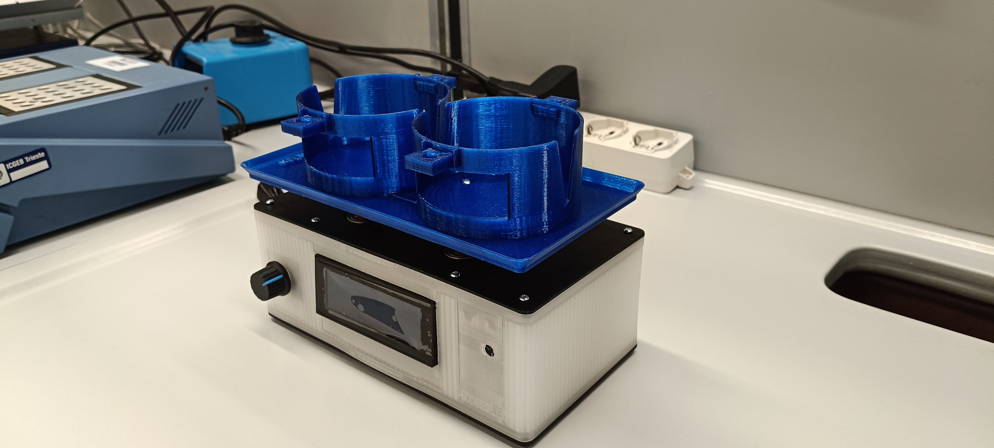
[picture p29: hardware/Shaker/Images/Assembled shaker/IMG20260604145818.jpg]
Assembled shaker view 11
      
    </td>
    <td align="center" width="33%">
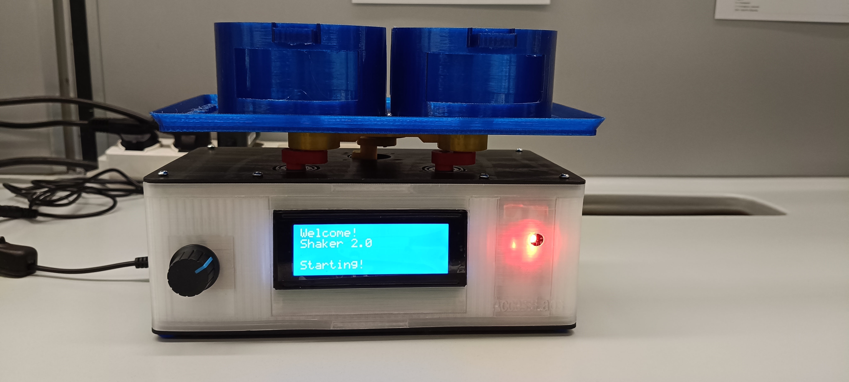
[picture p30: hardware/Shaker/Images/Assembled shaker/IMG20260604145831.jpg]
Assembled shaker view 12
      
    </td>
  </tr>
  <tr>
    <td align="center" width="33%">
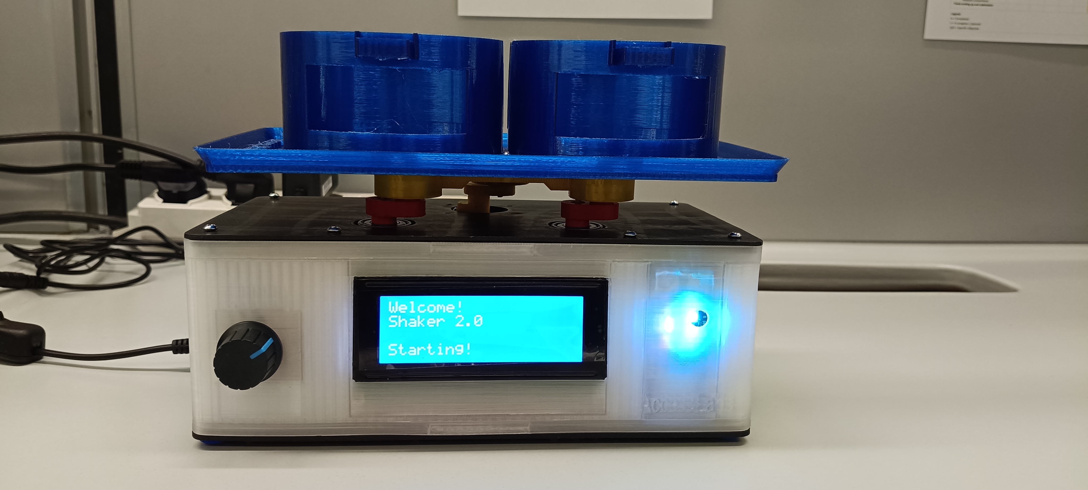
[picture p31: hardware/Shaker/Images/Assembled shaker/IMG20260604145834.jpg]
Assembled shaker view 13
      
    </td>
    <td align="center" width="33%">
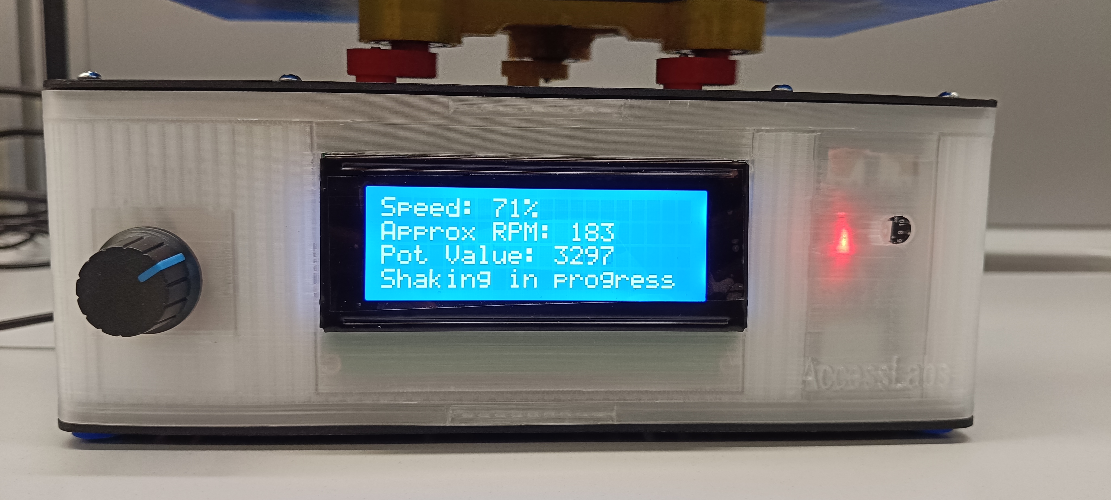
[picture p32: hardware/Shaker/Images/Assembled shaker/IMG20260604145857.jpg]
Assembled shaker view 14
      
    </td>
    <td align="center" width="33%">
      <!-- Empty cell for layout balance -->
    </td>
  </tr>
</table>

<p align="center">
  Animated view of the fully assembled shaker
</p>

### I. Operation

1. Power the shaker.
2. Place the correct adapter on the tray.
3. Load vessels symmetrically.
4. Increase speed gradually using the potentiometer.
5. Monitor for:
   - vibration
   - imbalance movements
   - slipping vessels
   - overheating

For best results:
- balance the load evenly
- avoid overloading one side
- start at low speed after every configuration change

### I. Final system test after full assembly

After completing the mechanical assembly and closing the enclosure, run a final system test before regular use. This test confirms that the electronics, firmware, motion mechanism, tray, and selected adapter work correctly together as a complete system.

#### Fully assembled system test video

Click the preview below to download the full system test video.

<p align="center">
  <a href="Assembly-and-set-up/Fully%20assembled%20Final%20system%20test%20video.mp4">
    Fully assembled shaker system test video preview
  </a>
</p>

---

## Safety

- Use the device on a stable, level surface.
- Do not operate with loose hardware.
- Do not touch moving parts during operation.
- Keep liquids away from exposed electronics.
- Verify adapter fit before placing samples.
- Disconnect power before maintenance or rewiring.
- Inspect glued nuts, bearings, and fasteners regularly.

---

## ⚠️ Known limitations

- 🧭 **RPM is estimated, not directly measured.**  
  The current design does not use an encoder or tachometer, so the displayed or expected RPM is based on motor control settings rather than closed-loop speed feedback.

- ⚙️ **Motor performance may vary.**  
  The actual shaking speed and stability can depend on the motor quality, load, adapter type, vessel weight, and power supply used.

- ⏱️ **Long-duration operation has not been fully validated.**  
  For prolonged use, such as continuous operation for approximately **48 hours or more**, a higher-quality or more suitable motor may be required.

- 🌡️ **Heat and wear should be monitored.**  
  During extended operation, check for motor heating, bearing wear, loose fasteners, and mechanical drift.

- ⚖️ **Load balance is important.**  
  Uneven loading of flasks, tubes, or plates may cause vibration, wobble, or reduced motor performance.

- 🧊 **The shaker does not provide temperature control.**  
  It is designed to fit inside a small laboratory incubator and operate as a shaking platform within that environment.

- 📝 **Documentation may evolve.**  
  The design files, assembly instructions, and firmware may be updated as the mechanical design is refined and additional testing is completed.

---

## 🤝 Contributing

Improvements, suggestions, and validation data are welcome.

Useful contributions include:

- 🔧 **Motor recommendations**  
  Suggestions for a more suitable motor, especially for stable RPM control and prolonged operation.

- 📊 **Validation data**  
  RPM measurements, load tests, long-duration tests, temperature-related performance checks, and general performance observations.

- 🧪 **Adapter variants**  
  New adapter designs for additional vessels or labware beyond flasks, tubes, and plates.

- 🏗️ **Mechanical design improvements**  
  Improvements related to stability, balance, durability, compactness, and ease of assembly.

- 💻 **Firmware improvements**  
  Better speed control, calibration features, safety limits, display improvements, or optional encoder support.

- 🧩 **Custom PCB design**  
  A compact PCB to simplify the electronics, reduce wiring, improve reliability, and lower the overall cost.

- 📚 **Documentation improvements**  
  Clarification requests or improvements for unclear assembly steps.

Contributions can be proposed through issues, pull requests, or design discussions.
---

If you use or adapt this design, consider linking back to the original repository and documenting your modifications.
