Reclone-org/AccessLabs-Resources/hardware/Shaker/BOM/BOM.pdf

N/O | Item | Visual | Cost | Qty | Link | Comment
Enclosure and Mechanism
1 | 608zz Miniature Double Protection Metal Ball Bearings for Skateboarding Roller Inline Skates 8mm x 22mm x 7mm | | €10.99 | 1 | Amazon (https://www.amazon.it/-/en/dp/B0D9JWYDJW?ref=ppx_yo2ov_dt_b_fed_asin_title) | /
2 | M3 Set of Screws, Bolts, Nuts and Washers Kit, Bolts Round Head Screws, Cross Head Cylindrical Screw, Machine Screw (Silver 870 Pieces M3)
€14.98 | 1 | Amazon (https://www.amazon.it/dp/B0D2Y81XP2?aref=lkiMCZhKil&sp_csd=d2lkZ2V0TmFtZT1zcF9kZXRhaWxfdGhlbWF0aWM) | /

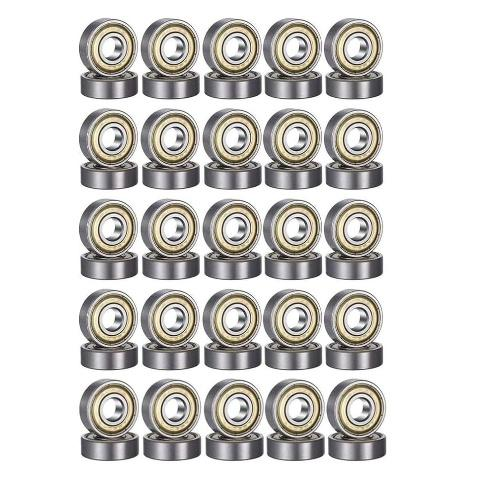
[picture p33: figure]
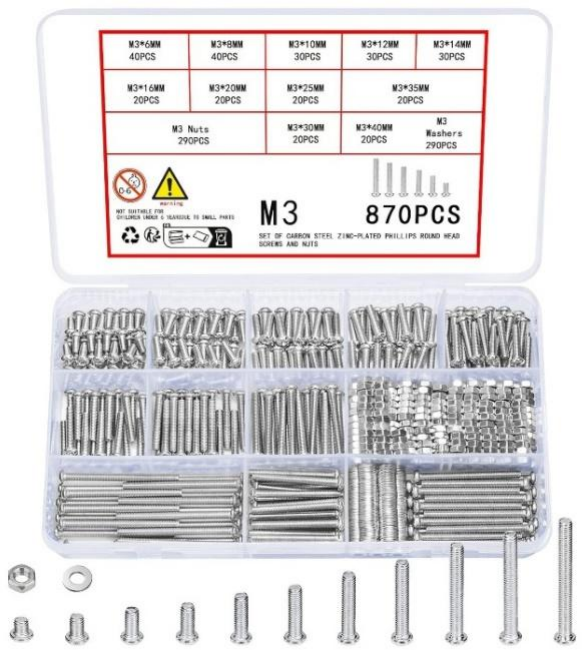
[picture p34: figure]

Electronics
N/O | Item | Visual | Cost | Qty | Link | Comment
3 | Microcontroller ESP32-S3 DevKitC-1 | | €22.99 | 1 | Amazon (https://www.amazon.it/ESP-32-S3-DevKitC-1-WROOM-1-N16R8-Development-Expansion-Bluetooth/dp/B0CJHHX7J2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) | /
4 | Motor Driver
DRV8871 DC Motor
Driver Board Bob
Drive Module 3.6A
PWM Control Port
Driver
€9.99 | 2 | Amazon (https://www.amazon.it/-/en/gp/product/B0DQCK7FLL/ref=ox_sc_act_title_3?smid=A3LPK55TBV547E&psc=1) | /

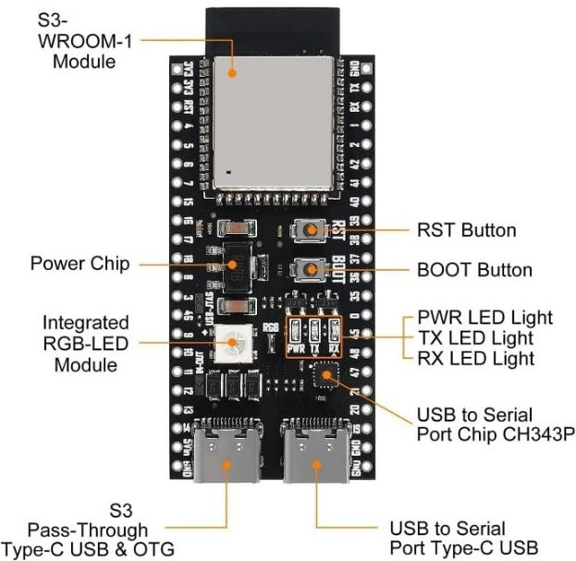
[picture p35: figure]
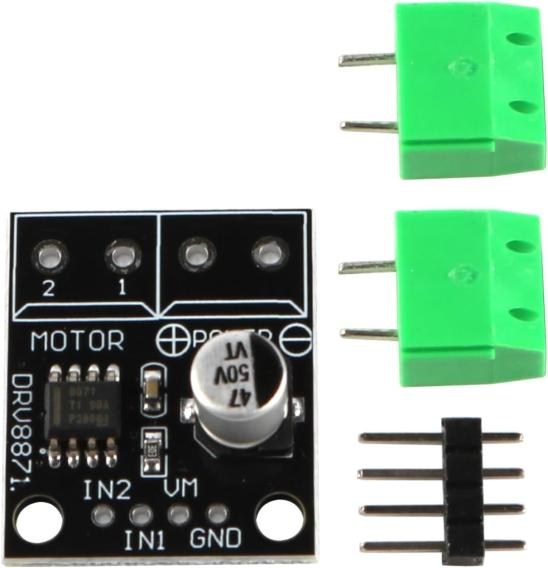
[picture p36: figure]

N/O | Item | Visual | Cost | Qty | Link | Comment
5 | Input Device 10K 3 Terminal Rotary Potentiometer for 10K Linear Potentiometer with Caps and Washer, 20PCS | | €9.99 | 1 | Amazon (https://www.amazon.it/-/en/RUNCCI-YUN-Terminal-Rotary-Potentiometer-Linear/dp/B07RHJZ979) | /

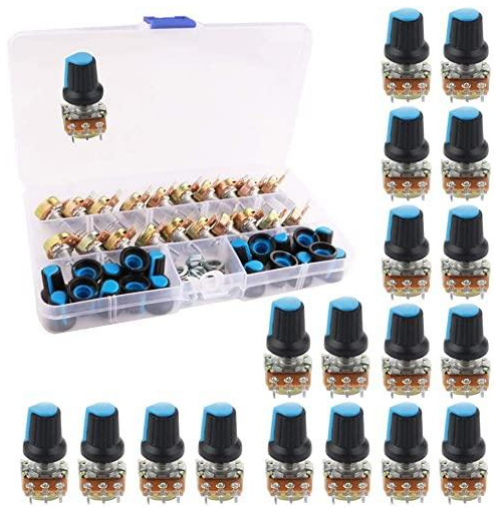
[picture p37: figure]

6 | DC Motor Worm Oriented Drive Motor; CHANCS 370WG 12V DC 375RPM for Range Hood Nesting Machine Intelligent Equipment | | €18.99 | 2 | Amazon (https://www.amazon.it/-/en/dp/B08MQ6D51J?ref=ppx_yo2ov_dt_b_fed_asin_title&th=1) | Preferred choice for cost-effectivenes s. Recommend ed using a similar motor with high torque and built from better materials for prolonged use.

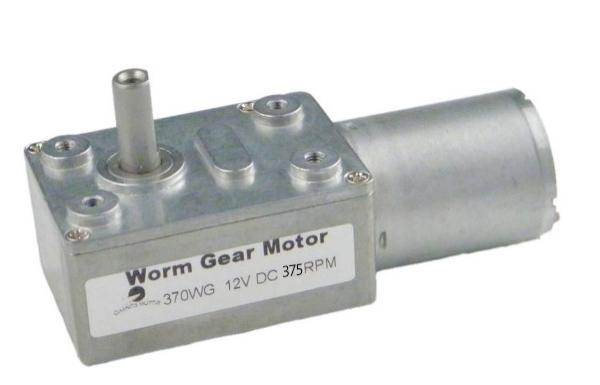
[picture p38: figure]
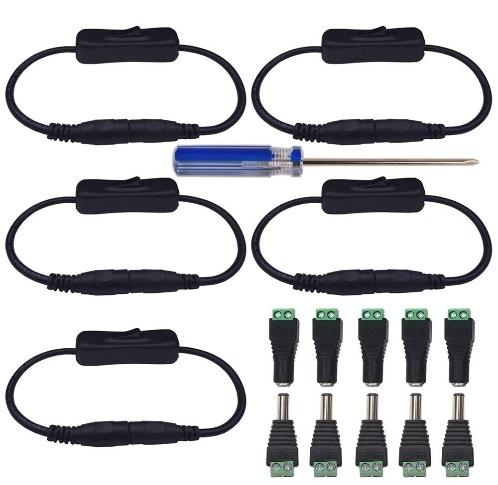
[picture p39: figure]

7 | Power Connector GTIWUNG 10 x DC Connector, DC Power Connectors, Barrel Power Jack Adapter 12 V Package includes: 5 Pairs DC 12V Connectors (Male + Female) 5 x Inline Rocker Switch | | €13.99 | 1 | Amazon (https://www.amazon.it/-/en/gp/product/B08GLZVS4T/ref=ox_sc_act_title_2?smid=A2ZY4SNMU91J2Q&psc=1) | /

N/O | Item | Visual | Cost | Qty | Link | Comment
8 | 12V Power Cable Zolt 36W 12V 3A Universal Power Supply, 12V 1A 2A 3A AC DC Adapter Transformer with 9 DC Plugs for Electronics, 3000 mA Max. | | €12.90 | 2 | Amazon (https://www.amazon.it/-/en/gp/product/B0B1TSC61N/ref=ewc_pr_img_1?smid=AFU1K3W40V8EX&psc=1) | /

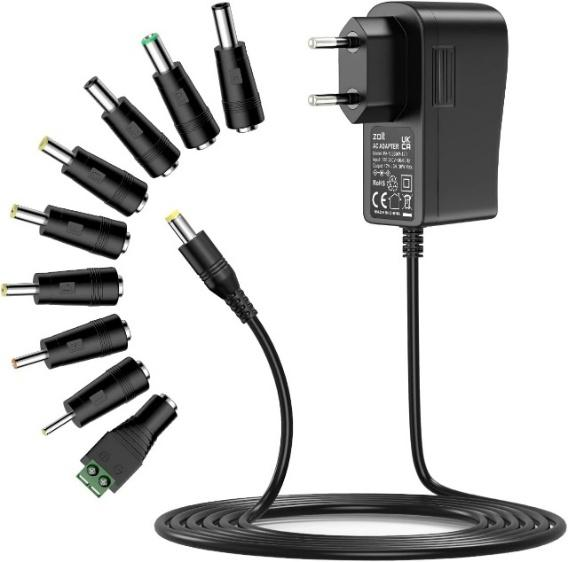
[picture p40: figure]

9 | LM2596S LM2596 Step-Down DC-DC Buck Converter Module for 4-40V to 3.3-24V with 3-Digit Digital Display,AZ-Delivery 3 x | | €11.19 | 1 | Amazon (https://www.amazon.it/-/en/AZ-Delivery-LM2596S-Step-Down-Converter-Including/dp/B08T1ZR6XG) | Required to safely power the entire circuit from a single 12V external adapter (via the DC jack)

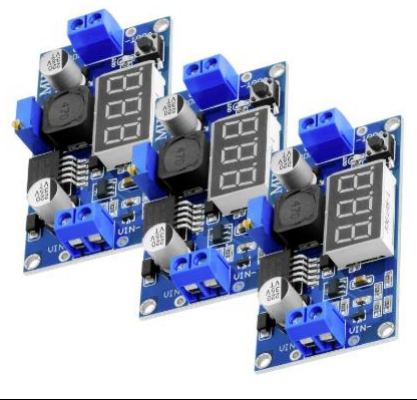
[picture p41: figure]
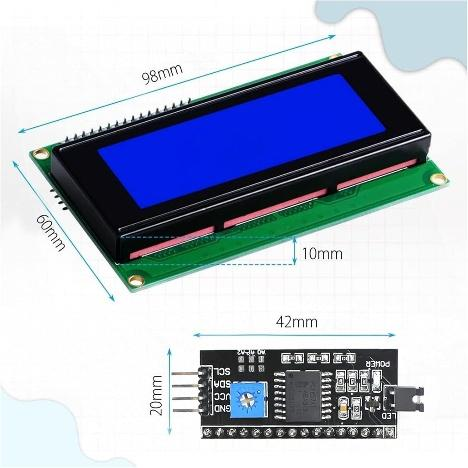
[picture p42: figure]

10 | LCD Display Module, ARCELI 20x4 2004 5V DC LCD Screen Display Module with TWI IIC I2C LCD Interface Adapter (Blue/2004) | | €10.77 | 1 | Amazon (https://www.amazon.it/dp/B0CM9H3MNX?ref=ppx_yo2ov_dt_b_fed_asin_title) | /
| | Total cost) | 136.87 EUR
