Reclone-org/AccessLabs-Resources/hardware/Shaker/3D models/Tray_Main Platform.stl

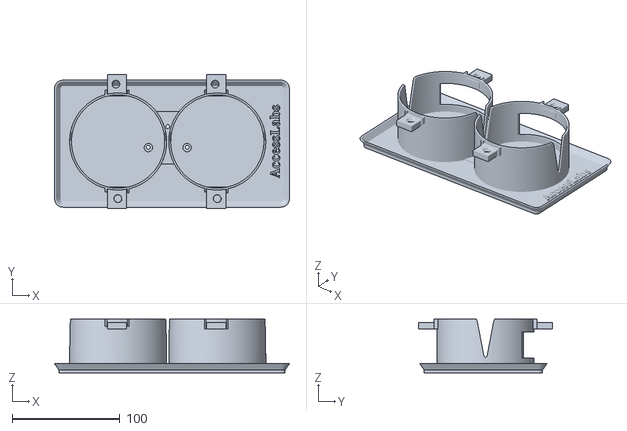
[picture p43: CAD file, 2026-03-27]
hardware/Shaker/3D models/Tray_Main Platform.stl
218.0 x 124.0 x 50.0
