Reclone-org/AccessLabs-Resources/hardware/Shaker/3D models/Enclosure_Main Housing.stl

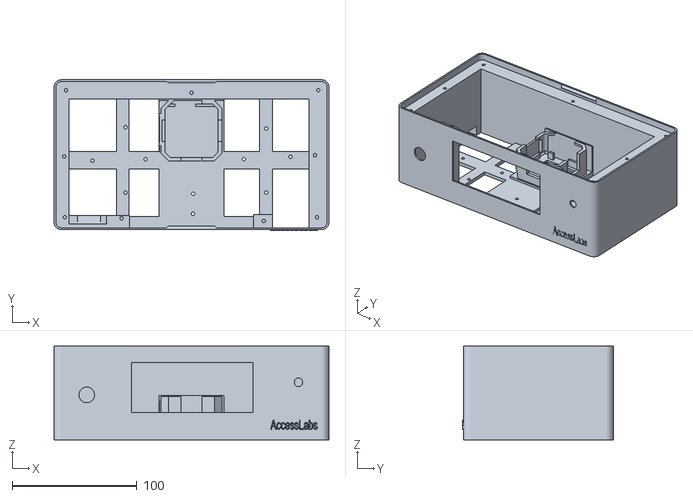
[picture p44: CAD file, 2026-03-27]
hardware/Shaker/3D models/Enclosure_Main Housing.stl
220.0 x 120.5 x 75.0
