Reclone-org/AccessLabs-Resources/hardware/Shaker/3D models/Motion Mechanism_Motor motion linker (6mm Shaft).stl

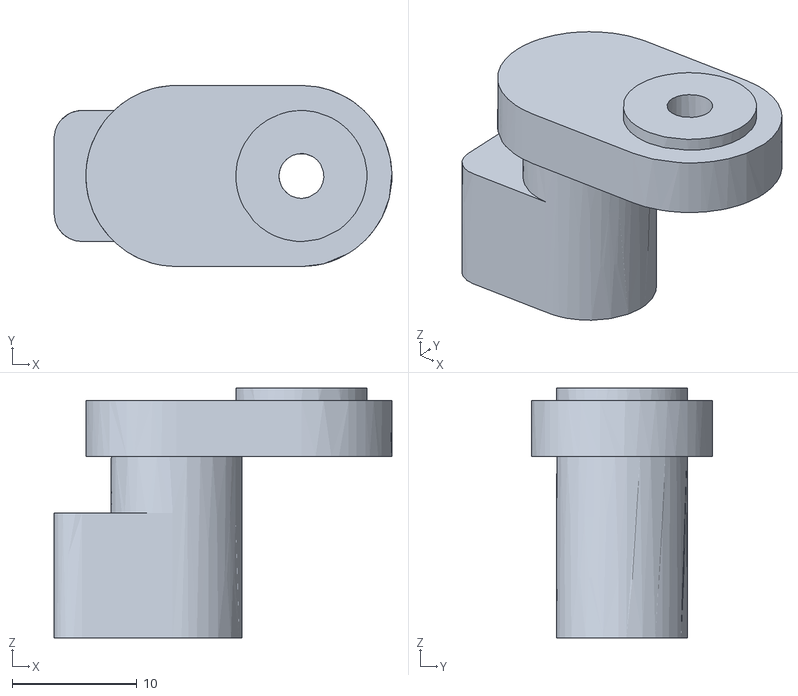
[picture p45: CAD file, 2026-06-01]
hardware/Shaker/3D models/Motion Mechanism_Motor motion linker (6mm Shaft).stl
27.1 x 14.5 x 20.0
