Reclone-org/AccessLabs-Resources/hardware/Shaker/3D models/Enclosure_Top Cover.stl

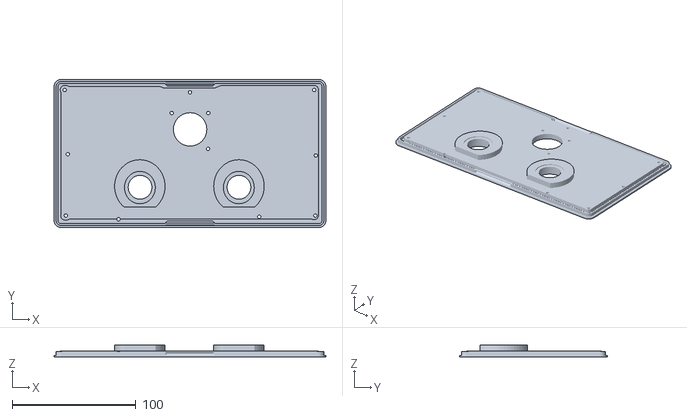
[picture p46: CAD file, 2026-06-01]
hardware/Shaker/3D models/Enclosure_Top Cover.stl
220.0 x 120.0 x 10.00
