Reclone-org/AccessLabs-Resources/hardware/Shaker/3D models/Flask adapter_Lid retainer (Print 1 set).stl

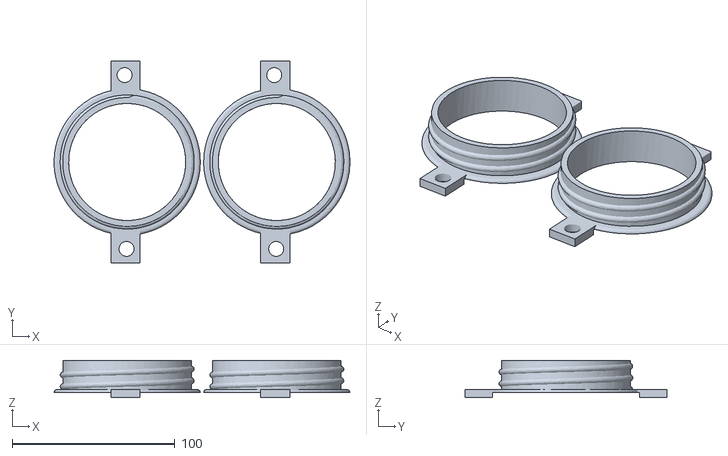
[picture p47: CAD file, 2026-03-27]
hardware/Shaker/3D models/Flask adapter_Lid retainer (Print 1 set).stl
182.0 x 124.0 x 23.0
