Reclone-org/AccessLabs-Resources/hardware/Shaker/3D models/Motion Mechanism_Tray Support Bracket.stl

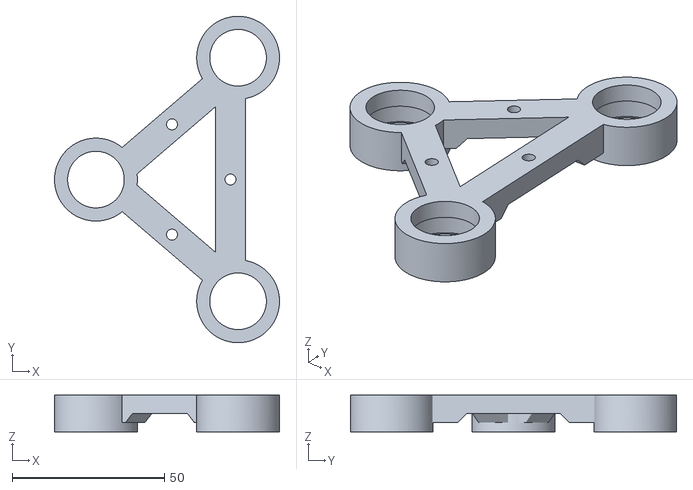
[picture p48: CAD file, 2026-03-27]
hardware/Shaker/3D models/Motion Mechanism_Tray Support Bracket.stl
73.9 x 107.2 x 12.0
