Reclone-org/AccessLabs-Resources/hardware/Shaker/3D models/Flask adapter_Lid_(Print 2 copies).stl

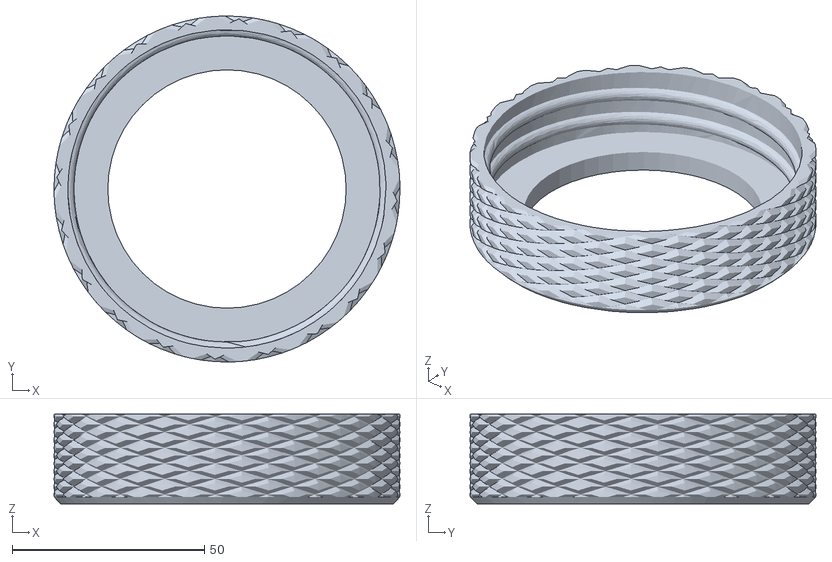
[picture p49: CAD file, 2026-03-27]
hardware/Shaker/3D models/Flask adapter_Lid_(Print 2 copies).stl
90.0 x 90.0 x 23.4
