Reclone-org/AccessLabs-Resources/hardware/Shaker/3D models/Plate adapter.stl

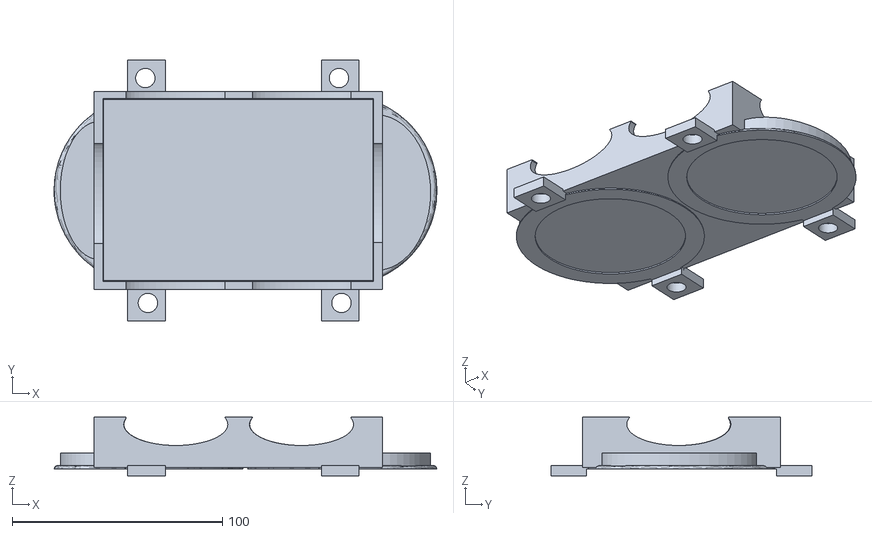
[picture p50: CAD file, 2026-03-27]
hardware/Shaker/3D models/Plate adapter.stl
182.0 x 124.0 x 28.0
