Reclone-org/AccessLabs-Resources/hardware/Shaker/3D models/Tube Adapter_15 mL and 50 mL.stl

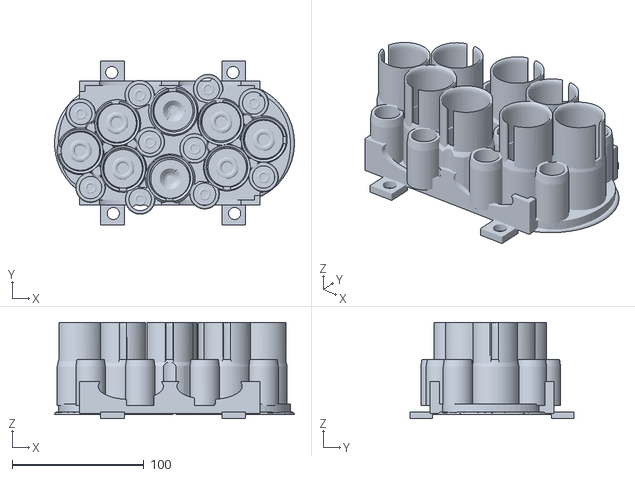
[picture p51: CAD file, 2026-03-27]
hardware/Shaker/3D models/Tube Adapter_15 mL and 50 mL.stl
182.0 x 124.0 x 73.0
