Reclone-org/AccessLabs-Resources/hardware/Shaker/3D models/Enclosure_Base Cover.stl

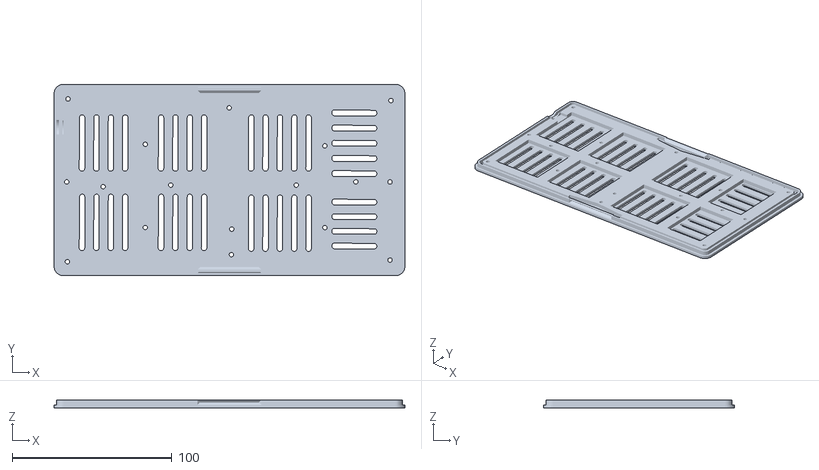
[picture p52: CAD file, 2026-03-27]
hardware/Shaker/3D models/Enclosure_Base Cover.stl
220.0 x 120.0 x 5.00
