Reclone-org/AccessLabs-Resources/hardware/Shaker/3D models/Enclosure_Feet.stl

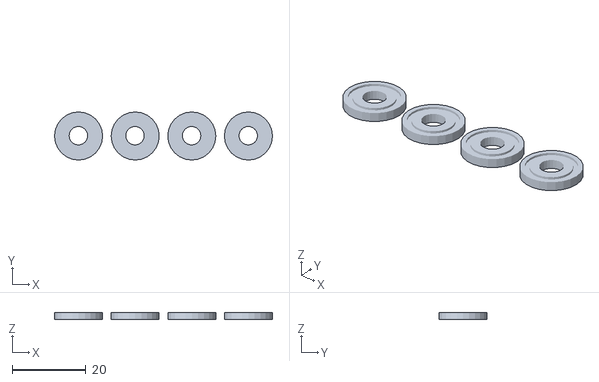
[picture p53: CAD file, 2026-03-27]
hardware/Shaker/3D models/Enclosure_Feet.stl
59.3 x 13.1 x 2.00
