Reclone-org/AccessLabs-Resources/hardware/Shaker/3D models/Motion Mechanism_Connecting Link (Print two copies).stl

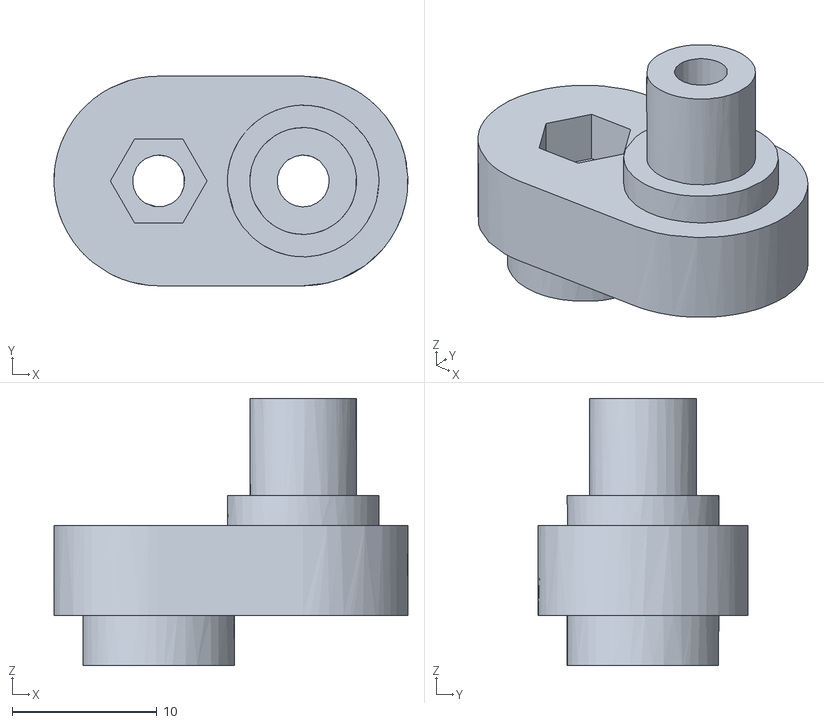
[picture p54: CAD file, 2026-03-27]
hardware/Shaker/3D models/Motion Mechanism_Connecting Link (Print two copies).stl
24.5 x 14.5 x 18.5
