Reclone-org/AccessLabs-Resources/hardware/Shaker/3D models/Enclosure_Gear Motor Mount.stl

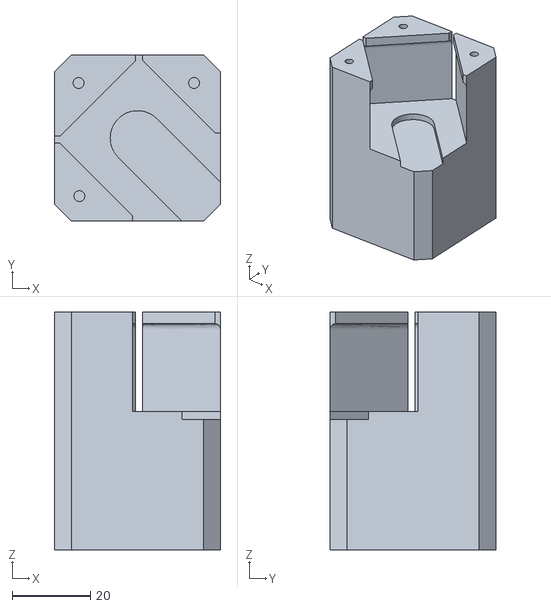
[picture p55: CAD file, 2026-03-27]
hardware/Shaker/3D models/Enclosure_Gear Motor Mount.stl
42.6 x 42.6 x 61.0
