Reclone-org/AccessLabs-Resources/hardware/Shaker/3D models/Motion Mechanism_Nut holders (Print two copies).stl

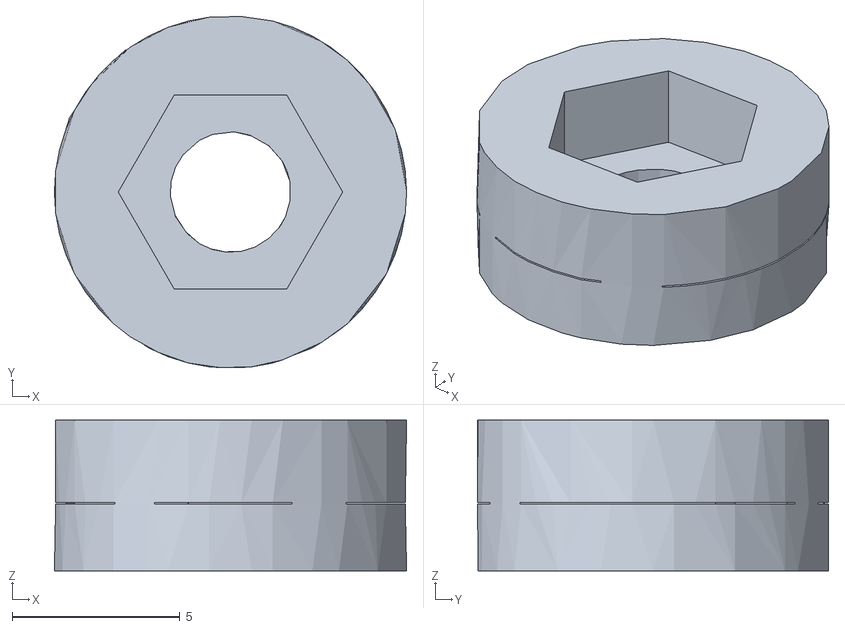
[picture p56: CAD file, 2026-03-27]
hardware/Shaker/3D models/Motion Mechanism_Nut holders (Print two copies).stl
10.5 x 10.5 x 4.50
