Reclone-org/AccessLabs-Resources/hardware/Shaker/3D models/Tray_Screws and nuts (Print 2 sets).stl

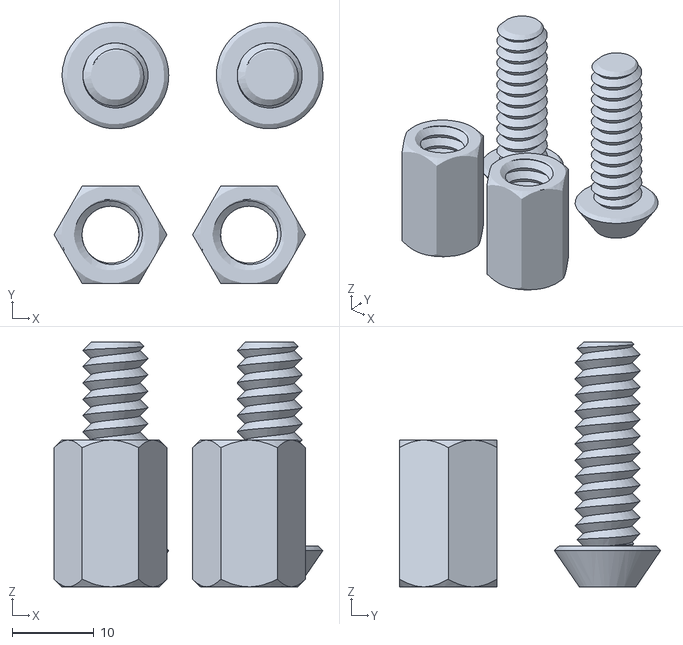
[picture p57: CAD file, 2026-03-27]
hardware/Shaker/3D models/Tray_Screws and nuts (Print 2 sets).stl
33.0 x 32.0 x 30.0
