Reclone-org/AccessLabs-Resources/hardware/Shaker/3D models/Motion Mechanism_Screw holders.stl

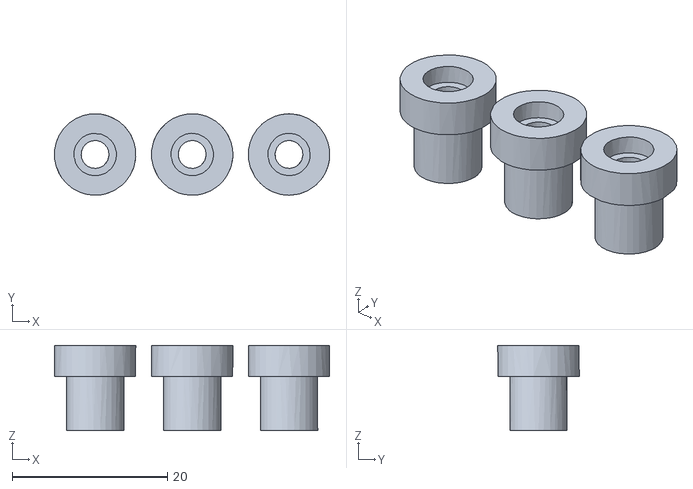
[picture p58: CAD file, 2026-03-27]
hardware/Shaker/3D models/Motion Mechanism_Screw holders.stl
35.4 x 10.5 x 11.0
