Reclone-org/AccessLabs-Resources/hardware/Shaker/Images/Assembled Shaker.jpg

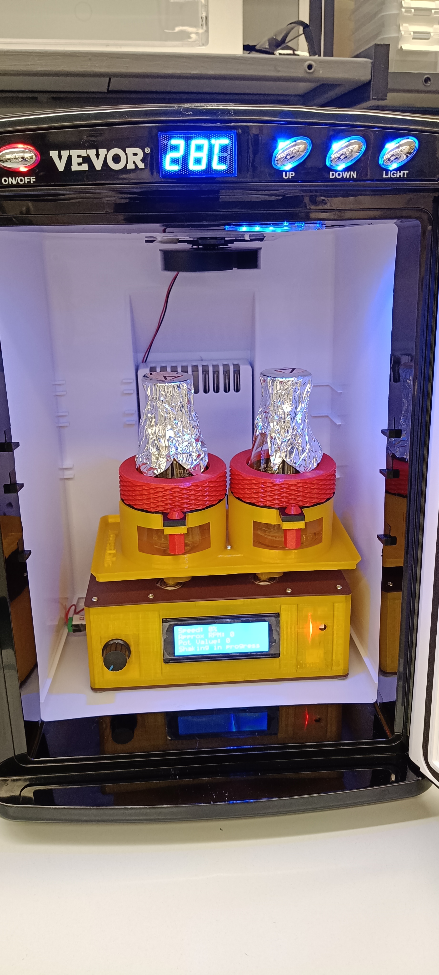
hardware/Shaker/Images/Assembled Shaker.jpg
