Reclone-org/AccessLabs-Resources/(commit log)

2026-03-17 Create BOM folder
2026-05-23 Added circuit diagram
2026-05-23 Added circuit design picture
2026-05-23 Added edited BOM file
2026-05-25 Added electronics assembly overview 1
2026-05-31 Rename Flask adapter_Lid retainer (Print 2 copies).stl to Flask adapter_Lid retainer (Print 1 set).stl
    [Flask adapter_Lid retainer (Print 1 set).stl]
2026-05-31 Rename Tray_Screws and nuts (Print 2 copies of each).stl to Tray_Screws and nuts (Print 2 sets).stl
    [Tray_Screws and nuts (Print 2 sets).stl]
2026-06-04 Rename IMG20260604165353.jpg to Assembled shaker2_1.jpg
2026-06-04 Rename IMG20260604171300.jpg to Assembled shaker2_2..jpg
